satspares/LDMOS_Controller/DWIN/Display 800x480/PS32/15.bmp

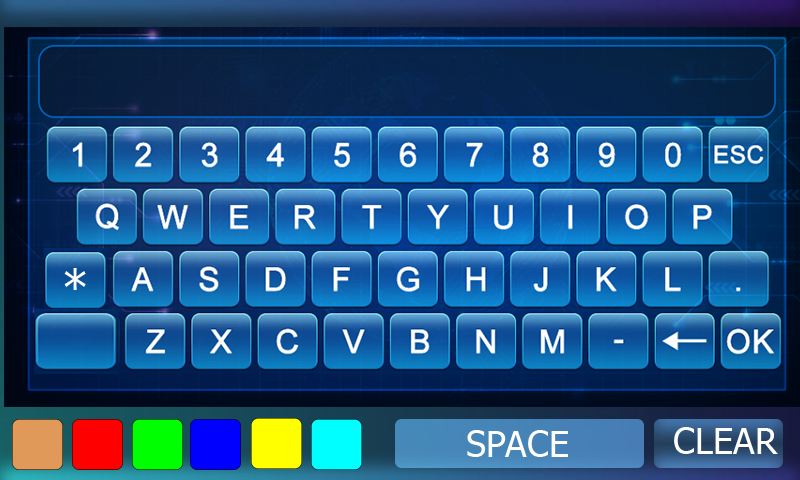
DWIN/Display 800x480/PS32/15.bmp
