satspares/LDMOS_Controller/README.md

# LDMOS_Controller
LDMOS Controller with DWIN Display
New October 2026
