satspares/LDMOS_Controller/Kicad/Kicad-all-band-amp-April-2026/all-band-amp-April-2026/report.txt

Info: Processing symbol 'L1:Inductor_THT:L_Radial_D7.0mm_P3.00mm'.
Info: Processing symbol 'J18:Connector_JST:JST_EH_B2B-EH-A_1x02_P2.50mm_Vertical'.
Info: Processing symbol 'J19:Connector_JST:JST_EH_B3B-EH-A_1x03_P2.50mm_Vertical'.
Info: Processing symbol 'J20:Connector_JST:JST_EH_B2B-EH-A_1x02_P2.50mm_Vertical'.
Info: Processing symbol 'J21:Connector_JST:JST_EH_B2B-EH-A_1x02_P2.50mm_Vertical'.
Info: Processing symbol 'J22:Connector_JST:JST_EH_B3B-EH-A_1x03_P2.50mm_Vertical'.
Info: Processing symbol 'J23:Connector_JST:JST_EH_B2B-EH-A_1x02_P2.50mm_Vertical'.
Info: Processing symbol 'J24:Connector_JST:JST_EH_B2B-EH-A_1x02_P2.50mm_Vertical'.
Info: Processing symbol 'J25:Connector_JST:JST_EH_B3B-EH-A_1x03_P2.50mm_Vertical'.
Info: Processing symbol 'JP1:Connector_Wire:SolderWire-0.5sqmm_1x02_P4.8mm_D0.9mm_OD2.3mm'.
Info: Processing symbol 'A1:my-footprints:DIP-34_W15.24mm'.
Info: Processing symbol 'J17:Connector_JST:JST_EH_B2B-EH-A_1x02_P2.50mm_Vertical'.
Info: Processing symbol 'Q1:Package_TO_SOT_THT:TO-92_HandSolder'.
Info: Processing symbol 'R1:Resistor_THT:R_Axial_DIN0207_L6.3mm_D2.5mm_P7.62mm_Horizontal'.
Info: Processing symbol 'R2:Resistor_THT:R_Axial_DIN0207_L6.3mm_D2.5mm_P7.62mm_Horizontal'.
Info: Processing symbol 'R3:Resistor_THT:R_Axial_DIN0207_L6.3mm_D2.5mm_P7.62mm_Horizontal'.
Info: Processing symbol 'R4:Resistor_THT:R_Axial_DIN0207_L6.3mm_D2.5mm_P7.62mm_Horizontal'.
Info: Processing symbol 'R5:Resistor_THT:R_Axial_DIN0207_L6.3mm_D2.5mm_P7.62mm_Horizontal'.
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
Updated J25 fields.
Updated J24 sheetfile to 'all-band-amp-2026.kicad_sch'.
Updated J24 sheetname to '/'.
Updated J24 fields.
Updated C15 fields.
Updated J23 sheetfile to 'all-band-amp-2026.kicad_sch'.
Updated J23 sheetname to '/'.
Updated J23 fields.

Info: Total warnings: 0, errors: 0.
