satspares/LDMOS_Controller/DWIN/Display 800x480/DWIN_SET/0.bmp

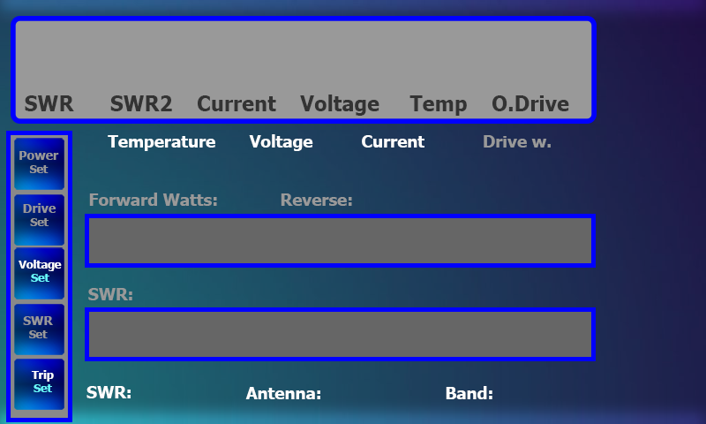
DWIN/Display 800x480/DWIN_SET/0.bmp
