satspares/LDMOS_Controller/DWIN/Display 800x480/DWIN_SET/10.bmp

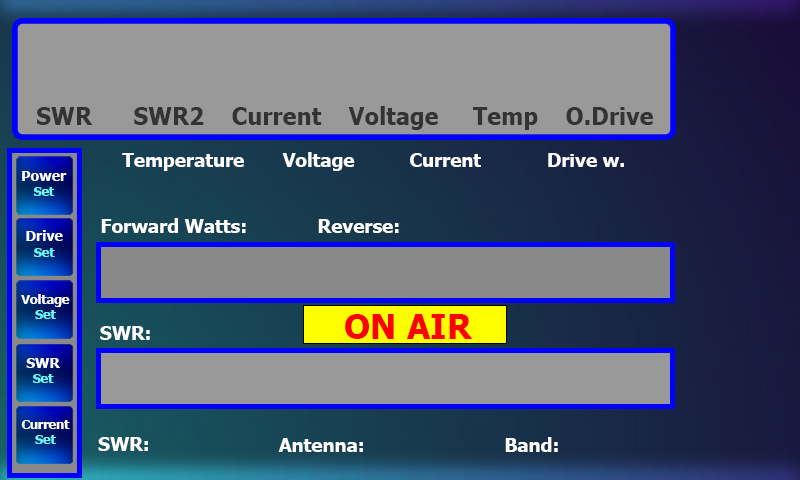
DWIN/Display 800x480/DWIN_SET/10.bmp
