satspares/LDMOS_Controller/DWIN/Display 800x480/PS32/dark.png

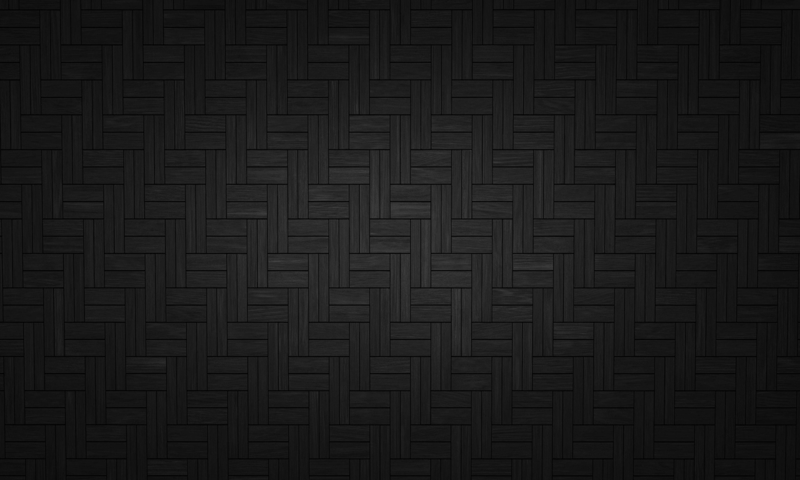
DWIN/Display 800x480/PS32/dark.png
