satspares/LDMOS_Controller/DWIN/Display_800x480_Single_Band/DWIN_SET/0.bmp

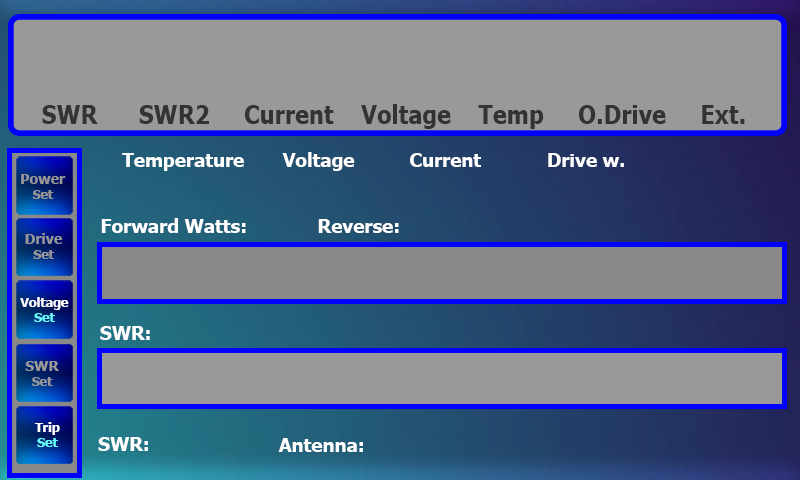
DWIN/Display_800x480_Single_Band/DWIN_SET/0.bmp
