satspares/LDMOS_Controller/DWIN/Display_800x480_Single_Band/PS32/16.bmp

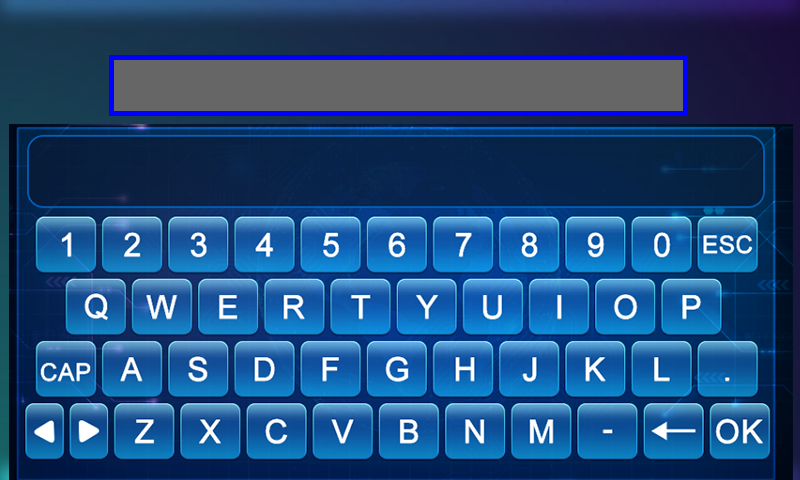
DWIN/Display_800x480_Single_Band/PS32/16.bmp
