satspares/LDMOS_Controller/Kicad/RFA_Board/sm_red_top.png

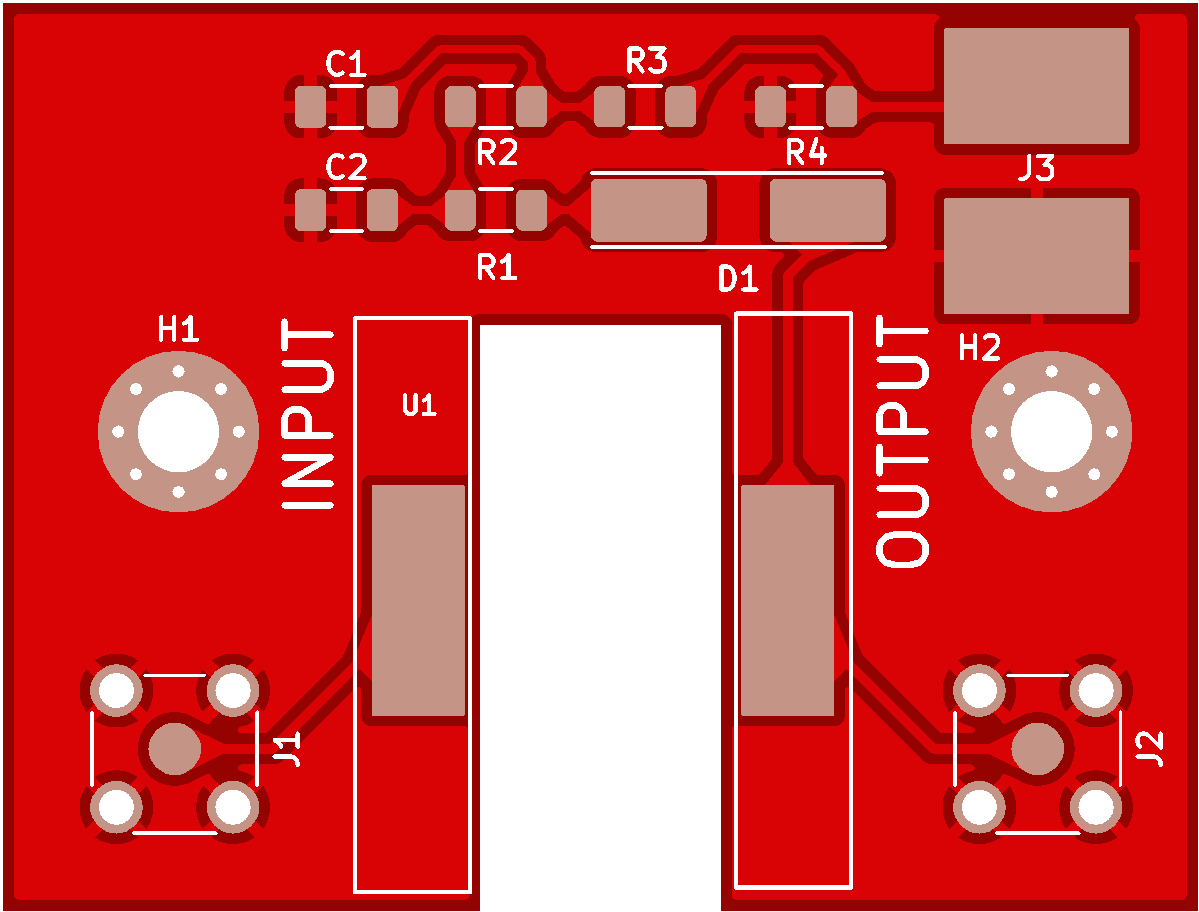
Kicad/RFA_Board/sm_red_top.png
