satspares/LDMOS_Controller/Kicad/Band_Switch_board_2026/components.txt

Capacitor_THT:C_Disc_D3.4mm_W2.1mm_P2.50mm

Capacitor_THT:C_Disc_D6.0mm_W2.5mm_P5.00mm

Diode_THT:D_DO-35_SOD27_P7.62mm_Horizontal

Resistor_THT:R_Axial_DIN0207_L6.3mm_D2.5mm_P7.62mm_Horizontal
