satspares/LDMOS_Controller/Kicad/LTC-7001-Trip_B-SMD-Mod/production/bom.csv

Designator | Footprint | Quantity | Value | LCSC Part #
C1, C13 | C_Disc_D3.8mm_W2.6mm_P2.50mm | 2 | 100nf 100v
C10, C11 | C_Disc_D3.8mm_W2.6mm_P2.50mm | 2 | 10uf
C12, C4 | C_Disc_D3.8mm_W2.6mm_P2.50mm | 2 | 10nf
C2, C22, C3, C6, C8, C9 | C_Disc_D3.8mm_W2.6mm_P2.50mm | 6 | 100nf
C23 | CP_Radial_D10.0mm_P5.00mm | 1 | 10uf-220uf 100v
C25, C27, C7 | C_Disc_D3.4mm_W2.1mm_P2.50mm | 3 | 10nf
C5 | C_Disc_D3.8mm_W2.6mm_P2.50mm | 1 | 1uf
CN1 | CONN-TH_8P-P2.54_KF141R-2.54-8P | 1 | ~
D1, D3 | D_DO-41_SOD81_P10.16mm_Horizontal | 2 | UF4007
D2 | D_DO-35_SOD27_P7.62mm_Horizontal | 1 | 5.1v Zener
FB1, FB2 | 1206 | 2 | Ferrite
IC1 | SOP50P490X110-11N | 1 | LTC7001HMSE#PBF
K2 | HK4100FDC5VSHG | 1 | HK4100F-DC12V-SHG
Q1 | IAUT150N10S5N035ATMA1 | 1 | IPT010N08NM5ATM1
Q2, Q3, Q4, Q5, Q7 | TO-92-mod2 | 5 | 2N7000
Q6 | TO-92_HandSolder | 1 | bc547
R1 | R_Axial_DIN0207_L6.3mm_D2.5mm_P7.62mm_Horizontal | 1 | 10r
R10, R12, R8 | R_Axial_DIN0207_L6.3mm_D2.5mm_P7.62mm_Horizontal | 3 | 1k
R11, R14, R7, R9 | R_Axial_DIN0207_L6.3mm_D2.5mm_P7.62mm_Horizontal | 4 | 10k
R13 | R_Axial_DIN0207_L6.3mm_D2.5mm_P7.62mm_Horizontal | 1 | 2k2
R2, R3 | RESC11050X120N | 2 | 100r
R4 | R_Axial_DIN0207_L6.3mm_D2.5mm_P7.62mm_Horizontal | 1 | 47k
R43 | RESC11050X120N | 1 | Shunt I>30a
R5 | R_Axial_DIN0207_L6.3mm_D2.5mm_P7.62mm_Horizontal | 1 | 4k7
R6 | R_Axial_DIN0207_L6.3mm_D2.5mm_P7.62mm_Horizontal | 1 | 100k
RV1 | Potentiometer_Bourns_3296W_Vertical | 1 | 1k
SW1 | SW_PUSH_6mm | 1 | Test Enable
TP1 | TestPoint_THTPad_3.0x3.0mm_Drill1.5mm | 1 | LM393 - in
TP2 | TestPoint_THTPad_3.0x3.0mm_Drill1.5mm | 1 | +5v
TP3 | TestPoint_THTPad_3.0x3.0mm_Drill1.5mm | 1 | i_Sense
TP4 | TestPoint_THTPad_3.0x3.0mm_Drill1.5mm | 1 | INP
U1 | SOP-8_3.76x4.96mm_P1.27mm | 1 | LMV393
U2 | TO-92_Inline-mod | 1 | L78L05_TO92
U9 | SOIC-8_3.9x4.9mm_P1.27mm | 1 | ACS712xLCTR-30A
