satspares/LDMOS_Controller/Kicad/Kicad-all-band-amp-April-2026/all-band-amp-April-2026/production/bom.csv

Designator | Footprint | Quantity | Value | LCSC Part #
A1 | DIP-34_W15.24mm | 1 | Arduino_Nano_Every-4808
C1, C18, C19, C2, C20, C21, C25, C26, C27, C3, C4, C5, C6 | C_Disc_D3.4mm_W2.1mm_P2.50mm | 13 | 10nf
C10, C17 | CP_Radial_D5.0mm_P2.00mm | 2 | 2.2uf
C11, C7 | CP_Radial_D5.0mm_P2.00mm | 2 | 10uf
C12, C22, C24, C8, C9 | C_Disc_D6.0mm_W2.5mm_P5.00mm | 5 | 100nf
C13, C14, C15, C16 | CP_Radial_D5.0mm_P2.00mm | 4 | 1uf
C23 | CP_Radial_D10.0mm_P5.00mm | 1 | 10uf-220uf
D1, D2, D3, D4, D5, D6 | D_DO-35_SOD27_P7.62mm_Horizontal | 6 | Zener 4.7v
D10, D11, D12, D7, D8, D9 | D_DO-35_SOD27_P7.62mm_Horizontal | 6 | BAT85
FB1, FB2, FB4, FB5, FB6, FB7, FB8, FB9 | 1206 | 8 | Ferrite
J1 | JST_EH_B3B-EH-A_1x03_P2.50mm_Vertical-mod2 | 1 | SWR1
J10 | JST_EH_B2B-EH-A_1x02_P2.50mm_Vertical-Mod | 1 | Aux In
J11 | JST_EH_B8B-EH-A_1x08_P2.50mm_Vertical | 1 | LPF
J12 | JST_EH_B4B-EH-A_1x04_P2.50mm_Vertical-mod2 | 1 | Digi In/Out
J13 | JST_EH_B4B-EH-A_1x04_P2.50mm_Vertical-mod2 | 1 | 12v/5v Outputs
J14 | JST_EH_B2B-EH-A_1x02_P2.50mm_Vertical-Mod | 1 | TX2/RX2
J15 | JST_EH_B2B-EH-A_1x02_P2.50mm_Vertical-Mod | 1 | TX0/RX0
J16, J5 | JST_EH_B2B-EH-A_1x02_P2.50mm_Vertical-Mod | 2 | 50v In.
J17 | JST_EH_B2B-EH-A_1x02_P2.50mm_Vertical-Mod | 1 | PWM Out
J18 | JST_EH_B2B-EH-A_1x02_P2.50mm_Vertical-Mod | 1 | PTT IN
J19 | JST_EH_B3B-EH-A_1x03_P2.50mm_Vertical-mod2 | 1 | DISPLAY POWER
J2 | JST_EH_B3B-EH-A_1x03_P2.50mm_Vertical-mod2 | 1 | SWR2
J20 | JST_EH_B2B-EH-A_1x02_P2.50mm_Vertical-Mod | 1 | 5V Output
J21 | JST_EH_B2B-EH-A_1x02_P2.50mm_Vertical-Mod | 1 | RS232
J22 | JST_EH_B3B-EH-A_1x03_P2.50mm_Vertical | 1 | UDPI
J23, J24 | JST_EH_B2B-EH-A_1x02_P2.50mm_Vertical-Mod | 2 | 12v Output
J27, J28, J29, J30, J31 | JST_EH_B2B-EH-A_1x02_P2.50mm_Vertical-Mod | 5 | SWR trip out
J3 | JST_EH_B2B-EH-A_1x02_P2.50mm_Vertical-Mod | 1 | I opt Input
J4 | JST_EH_B2B-EH-A_1x02_P2.50mm_Vertical-Mod | 1 | RF In Level
J6 | JST_EH_B3B-EH-A_1x03_P2.50mm_Vertical-mod2 | 1 | Temp
J7 | JST_EH_B3B-EH-A_1x03_P2.50mm_Vertical-mod2 | 1 | Conn_01x03_Pin
J8 | JST_EH_B2B-EH-A_1x02_P2.50mm_Vertical-Mod | 1 | 12v Input
J9 | JST_EH_B4B-EH-A_1x04_P2.50mm_Vertical-mod2 | 1 | I2c Output
JP1 | SolderWire-0.5sqmm_1x02_P4.8mm_D0.9mm_OD2.3mm | 1 | Jumper 12v
JP2 | SolderWire-0.5sqmm_1x02_P4.8mm_D0.9mm_OD2.3mm | 1 | Jumper 5v
JP3, JP4 | SolderJumper-2_P1.3mm_Open_TrianglePad1.0x1.5mm | 2 | Jumper_2_Open
L1 | L_Radial_D7.0mm_P3.00mm | 1 | 68uh
L2 | L_Axial_L5.3mm_D2.2mm_P7.62mm_Horizontal_Vishay_IM-1 | 1 | 560uh
Q1, Q2 | TO-92_HandSolder | 2 | 2n2222
R1, R44, R45, R46, R9 | R_Axial_DIN0207_L6.3mm_D2.5mm_P7.62mm_Horizontal | 5 | 1k5
R10, R8 | R_Axial_DIN0207_L6.3mm_D2.5mm_P7.62mm_Horizontal | 2 | 100r
R11 | R_Axial_DIN0204_L3.6mm_D1.6mm_P5.08mm_Horizontal | 1 | 4k7
R12 | R_Axial_DIN0204_L3.6mm_D1.6mm_P5.08mm_Horizontal | 1 | 470r
R13 | R_Axial_DIN0207_L6.3mm_D2.5mm_P7.62mm_Horizontal | 1 | 100k
R14 | R_Axial_DIN0207_L6.3mm_D2.5mm_P7.62mm_Horizontal | 1 | 5k1
R15, R24, R25 | R_Axial_DIN0207_L6.3mm_D2.5mm_P7.62mm_Horizontal | 3 | 4k7
R16, R42 | R_Axial_DIN0207_L6.3mm_D2.5mm_P7.62mm_Horizontal | 2 | 2k2
R17, R18, R19 | R_Axial_DIN0207_L6.3mm_D2.5mm_P7.62mm_Horizontal | 3 | 10r
R2, R4 | R_Axial_DIN0207_L6.3mm_D2.5mm_P7.62mm_Horizontal | 2 | 680r
R20, R21, R22, R23, R26, R27, R30, R31, R32, R33, R36 | R_Axial_DIN0207_L6.3mm_D2.5mm_P7.62mm_Horizontal | 11 | 10k
R28, R29 | R_Axial_DIN0207_L6.3mm_D2.5mm_P7.62mm_Horizontal | 2 | 470r
R3, R7 | R_Axial_DIN0207_L6.3mm_D2.5mm_P7.62mm_Horizontal | 2 | 1k5-3k3
R34 | R_Axial_DIN0207_L6.3mm_D2.5mm_P7.62mm_Horizontal | 1 | 3k3
R35, R40, R47 | R_Axial_DIN0207_L6.3mm_D2.5mm_P7.62mm_Horizontal | 3 | 1k
R37, R38 | R_Axial_DIN0207_L6.3mm_D2.5mm_P7.62mm_Horizontal | 2 | R
R39, R41 | R_Axial_DIN0207_L6.3mm_D2.5mm_P7.62mm_Horizontal | 2 | 220k-1M
R43 | CHSA3920R0003F-MOD | 1 | Shunt I>30a
R48 | R_Axial_DIN0207_L6.3mm_D2.5mm_P7.62mm_Horizontal | 1 | DNF
R5 | R_Axial_DIN0207_L6.3mm_D2.5mm_P7.62mm_Horizontal | 1 | 470r or 47k opt
R6 | R_Axial_DIN0207_L6.3mm_D2.5mm_P7.62mm_Horizontal | 1 | 47k opt
RV1, RV2 | Potentiometer_Bourns_3299Y_Vertical | 2 | 1k
U1 | DIP-16_W7.62mm | 1 | LTV-847
U2 | DIP-28_W7.62mm | 1 | MCP23017_SP
U3 | DIP-8_W7.62mm | 1 | LM393
U4, U5 | DIP-18_W7.62mm_Socket | 2 | MIC2981/82YN
U6 | Converter_DCDC_RECOM_R-78E-0.5_THT | 1 | R-78E5.0-1.0
U7 | DIP-16_W7.62mm | 1 | MAX232N
U8 | DIP-8_W7.62mm | 1 | LTV-827
U9 | SOIC-8_3.9x4.9mm_P1.27mm | 1 | ACS712xLCTR-30A
