satspares/LDMOS_Controller/Kicad/Band_Switch_board_2026/Band_Switch_board_2026_small/KMDGX-8S-N/3D/KMDGX-8S-N.stp

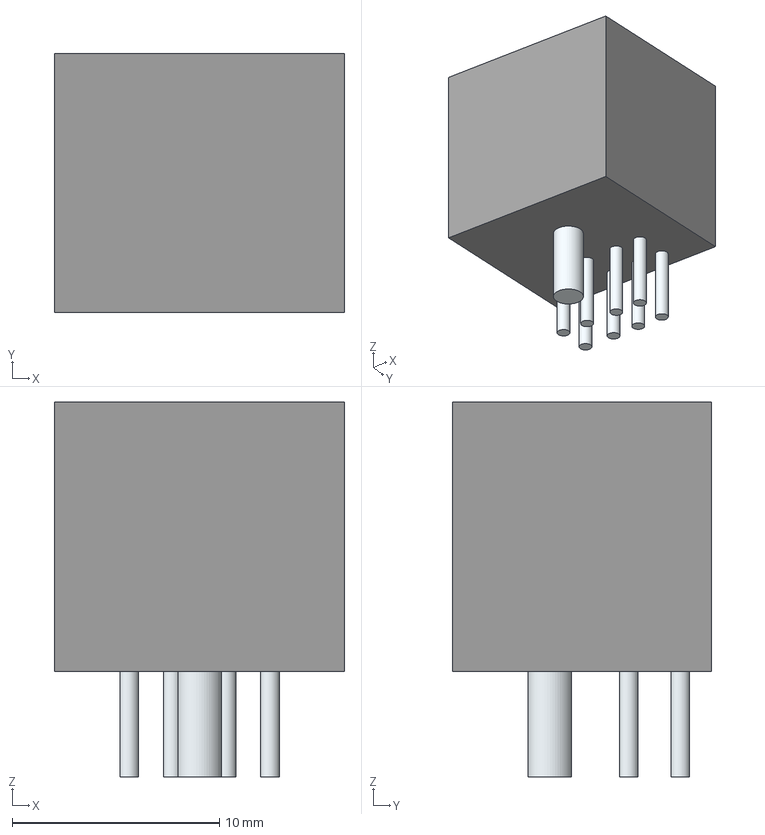
[picture p12: CAD file, 2026-10-16]
Kicad/Band_Switch_board_2026/Band_Switch_board_2026_small/KMDGX-8S-N/3D/KMDGX-8S-N.stp
14.0 x 12.5 x 18.1 mm
Leads x 9
