satspares/LDMOS_Controller/Kicad/Kicad-all-band-amp-April-2026/all-band-amp-April-2026/CHSA3920R0003F/3D/CHSA3920R0003F.stp

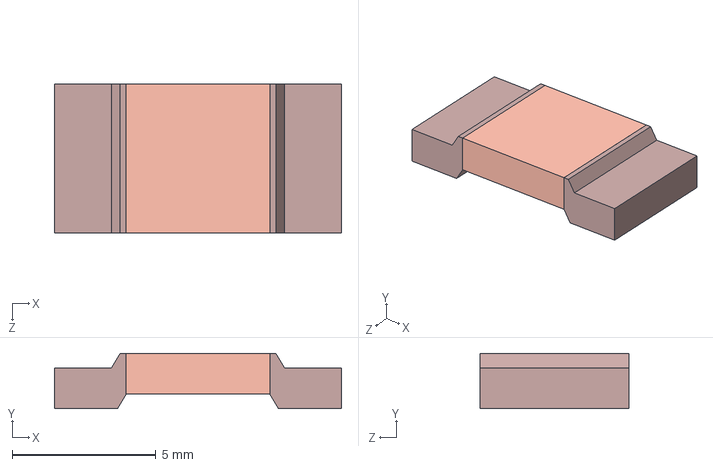
[picture p13: CAD file, 2026-10-16]
Kicad/Kicad-all-band-amp-April-2026/all-band-amp-April-2026/CHSA3920R0003F/3D/CHSA3920R0003F.stp
10.0 x 1.92 x 5.20 mm
