satspares/LDMOS_Controller/Kicad/RFA-Board-2026/RFA-Board-2026/IM26GR.stp

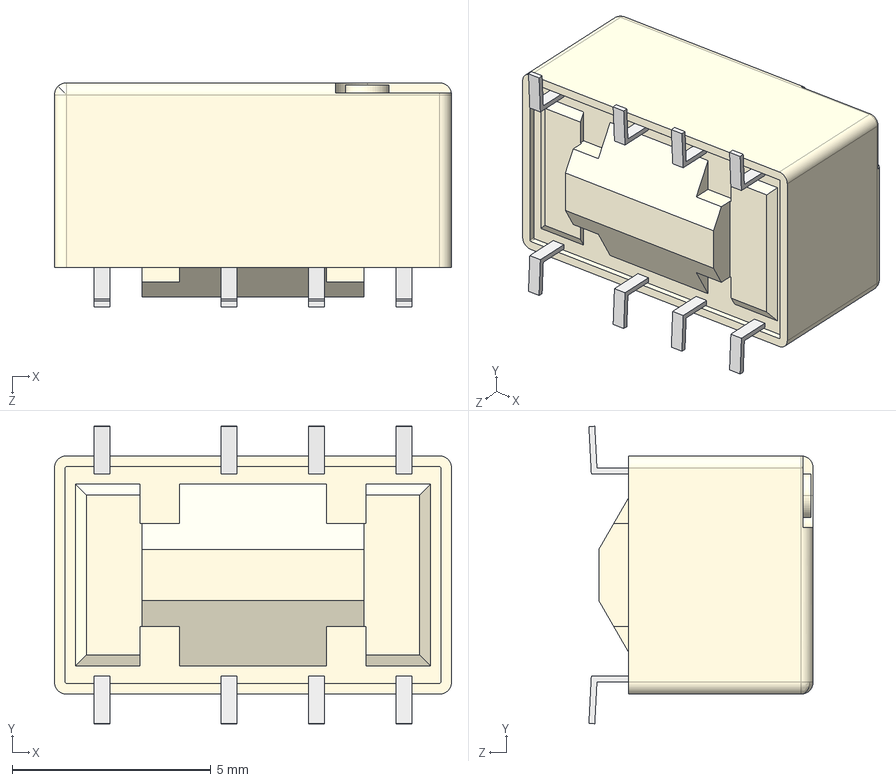
[picture p14: CAD file, 2026-10-16]
Kicad/RFA-Board-2026/RFA-Board-2026/IM26GR.stp
10.0 x 7.50 x 5.65 mm
