satspares/LDMOS_Controller/Kicad/N-CON_BOARD-2026-old/N-Con-Board-2026/Footprints/HK4100F-DC5V-SHG.step

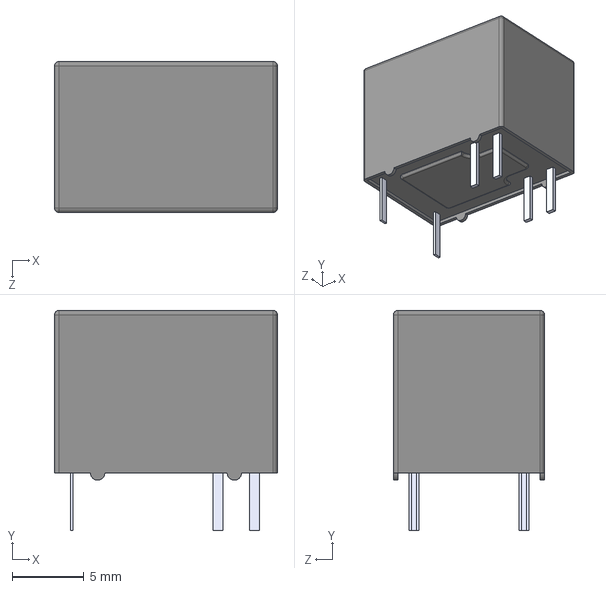
[picture p15: CAD file, 2026-10-16, an earlier design]
Kicad/N-CON_BOARD-2026-old/N-Con-Board-2026/Footprints/HK4100F-DC5V-SHG.step
15.5 x 15.3 x 10.5 mm
