satspares/LDMOS_Controller/(list of files, cad)

Other CAD files:
Kicad/Band_Switch_board_2026/Band_Switch_board_2026_small/KMDGX-8S-N/Allegro/kmdgx8sn.psm
Kicad/Band_Switch_board_2026/Band_Switch_board_2026_small/KMDGX-8S-N/DEHDL/kmdgx_8s_n/chips/chips.prt
Kicad/Kicad-all-band-amp-April-2026/all-band-amp-April-2026/CHSA3920R0003F/Allegro/chsa3920r0003f.psm
Kicad/Kicad-all-band-amp-April-2026/all-band-amp-April-2026/CHSA3920R0003F/DEHDL/chsa3920r0003f/chips/chips.prt
Kicad/RFA-Board-2026/RFA-Board-2026/3550100RJT/Allegro/resc11050x120n.psm
Kicad/RFA-Board-2026/RFA-Board-2026/3550100RJT/DEHDL/3550100rjt/chips/chips.prt
Kicad/RFA-Board-2026/RFA-Board-2026/IM26GR/Allegro/im07gr.psm
Kicad/RFA-Board-2026/RFA-Board-2026/IM26GR/DEHDL/im26gr/chips/chips.prt
