satspares/LDMOS_Controller/Kicad/LTC-7001-Trip_B-SMD-Mod/Symbols/DG141R-2.54.pdf

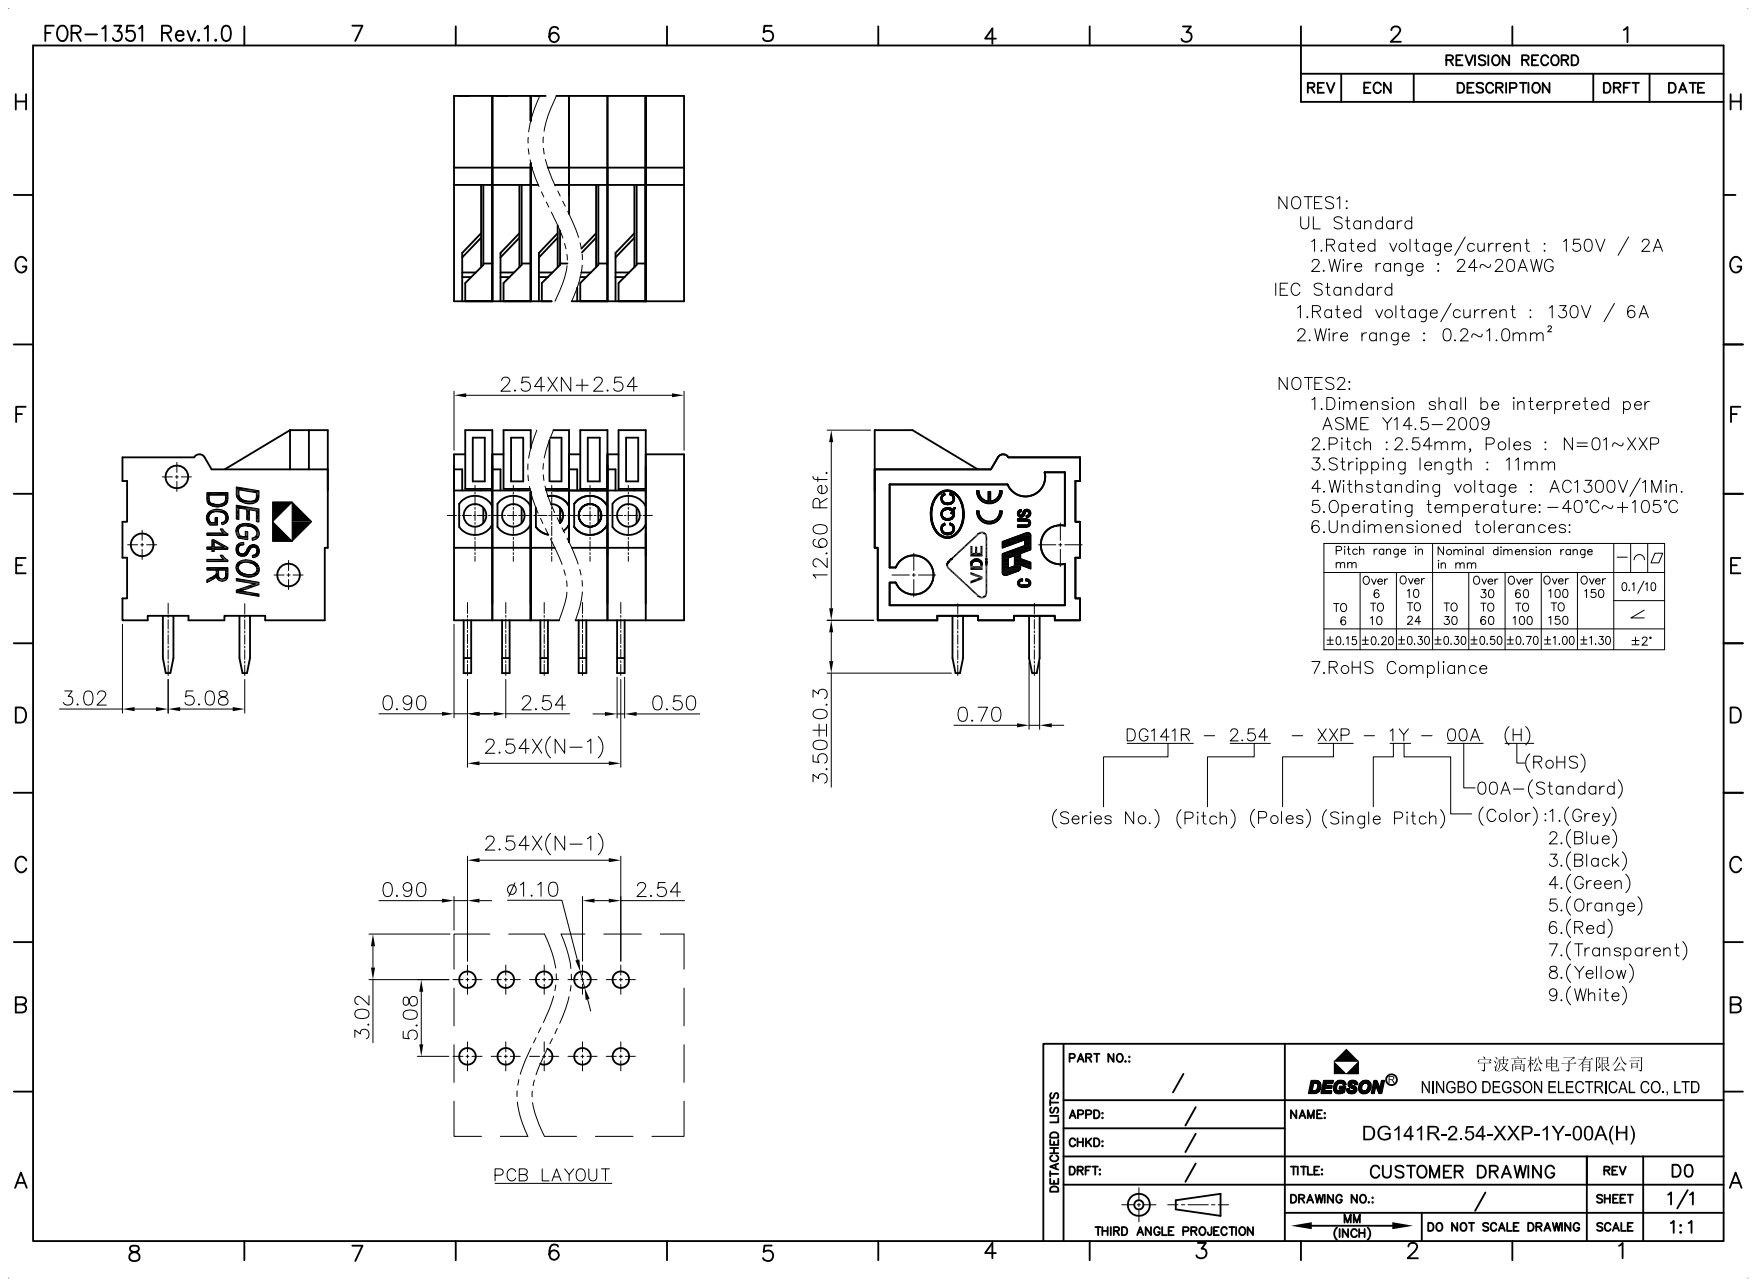
[picture p16: page 1]
