satspares/LDMOS_Controller/(list of files, drawings)

Other design files:
Kicad/Band_Switch_board_2026/Band_Switch_board_2026_small/KMDGX-8S-N/Altium/KMDGX8SN.PcbLib
Kicad/Band_Switch_board_2026/Band_Switch_board_2026_small/KMDGX-8S-N/Altium/KMDGX-8S-N.SchLib
Kicad/Kicad-all-band-amp-April-2026/all-band-amp-April-2026/CHSA3920R0003F/Altium/CHSA3920R0003F.PcbLib
Kicad/Kicad-all-band-amp-April-2026/all-band-amp-April-2026/CHSA3920R0003F/Altium/CHSA3920R0003F.SchLib
Kicad/RFA-Board-2026/RFA-Board-2026/3550100RJT/Altium/3550100RJT.SchLib
Kicad/RFA-Board-2026/RFA-Board-2026/3550100RJT/Altium/RESC11050X120N.PcbLib
Kicad/RFA-Board-2026/RFA-Board-2026/RFA-Board-2026.dsn
