satspares/LDMOS_Controller/Kicad/N-Con-Board-2026/N-Con-Board-2026.kicad_pcb

## KiCad design Kicad/N-Con-Board-2026/N-Con-Board-2026.kicad_pcb (2026-10-17)

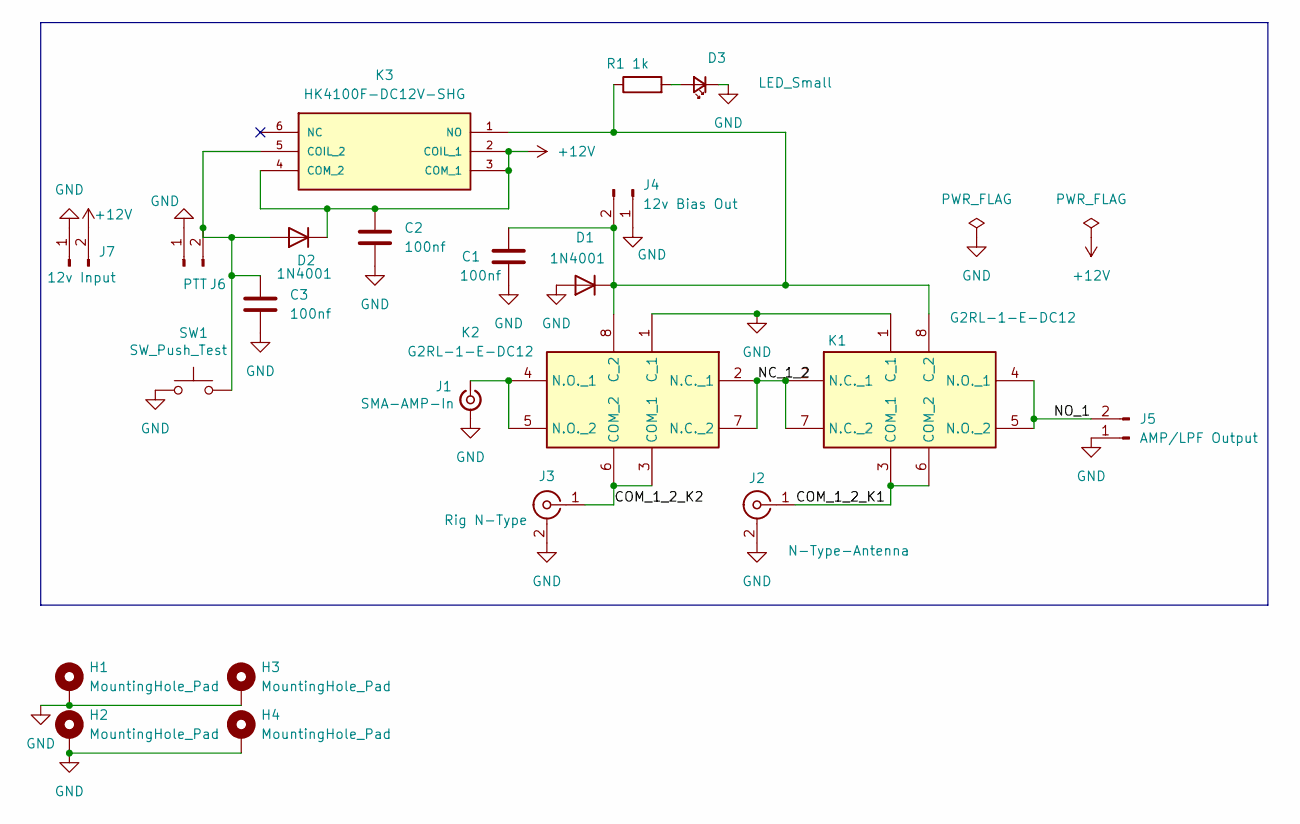
[picture p17: schematic N-Con-Board-2026.kicad_sch]

Parts:
C1, C2, C3: 100nf; C_Disc_D6.0mm_W2.5mm_P5.00mm
D1, D2: 1N4001; D_DO-41_SOD81_P10.16mm_Horizontal
D3: LED_Small; LED_D3.0mm
H1, H2, H3, H4: MountingHole_Pad; MountingHole_3.5mm_Pad_Via
J1: SMA-AMP-In; SMA_Amphenol_132134_Vertical
J2: N-Type-Antenna; N_TYPE
J3: Rig N-Type; N_TYPE
J4: 12v Bias Out; JST_EH_B2B-EH-A_1x02_P2.50mm_Vertical
J5: AMP/LPF Output; SolderWirePad_1x02_SMD_11x6mm
J6: PTT; JST_EH_B2B-EH-A_1x02_P2.50mm_Vertical
J7: 12v Input; JST_EH_B2B-EH-A_1x02_P2.50mm_Vertical
K1, K2: G2RL-1-E-DC12; G2RL1EDC24; Mouser Part Number 653-G2RL-1-E-DC12
K3: HK4100F-DC12V-SHG; HK4100FDC5VSHG; MANUFACTURER_PART_NUMBER HK4100F-DC5V-SHG
R1: 1k; R_Axial_DIN0207_L6.3mm_D2.5mm_P7.62mm_Horizontal
SW1: SW_Push_Test; SW_PUSH_6mm

Connections:
+12V: C2.1, D2.1 (K), J7.2, K3.2 (COIL_1), K3.3 (COM_1), K3.4 (COM_2)
/COM_1_2_K1: J2.1 (In), K1.3 (COM_1), K1.6 (COM_2)
/COM_1_2_K2: J3.1 (In), K2.3 (COM_1), K2.6 (COM_2)
/NC_1_2: K1.2 (N.C._1), K1.7 (N.C._2), K2.2 (N.C._1), K2.7 (N.C._2)
/NO_1: J5.2, K1.4 (N.O._1), K1.5 (N.O._2)
GND: C1.2, C2.2, C3.2, D1.2 (A), D3.1 (K), H1.1 (1_1), H2.1 (1_1), H3.1 (1_1), H4.1 (1_1), J1.2 (Ext), J2.2 (Ext), J3.2 (Ext), J4.1, J5.1, J6.1, J7.1, K1.1 (C_1), K2.1 (C_1), SW1.1
unnamed: C1.1, D1.1 (K), J4.2, K1.8 (C_2), K2.8 (C_2), K3.1 (NO), R1.1
unnamed: C3.1, D2.2 (A), J6.2, K3.5 (COIL_2), SW1.2
unnamed: D3.2 (A), R1.2
unnamed: J1.1 (In), K2.4 (N.O._1), K2.5 (N.O._2)

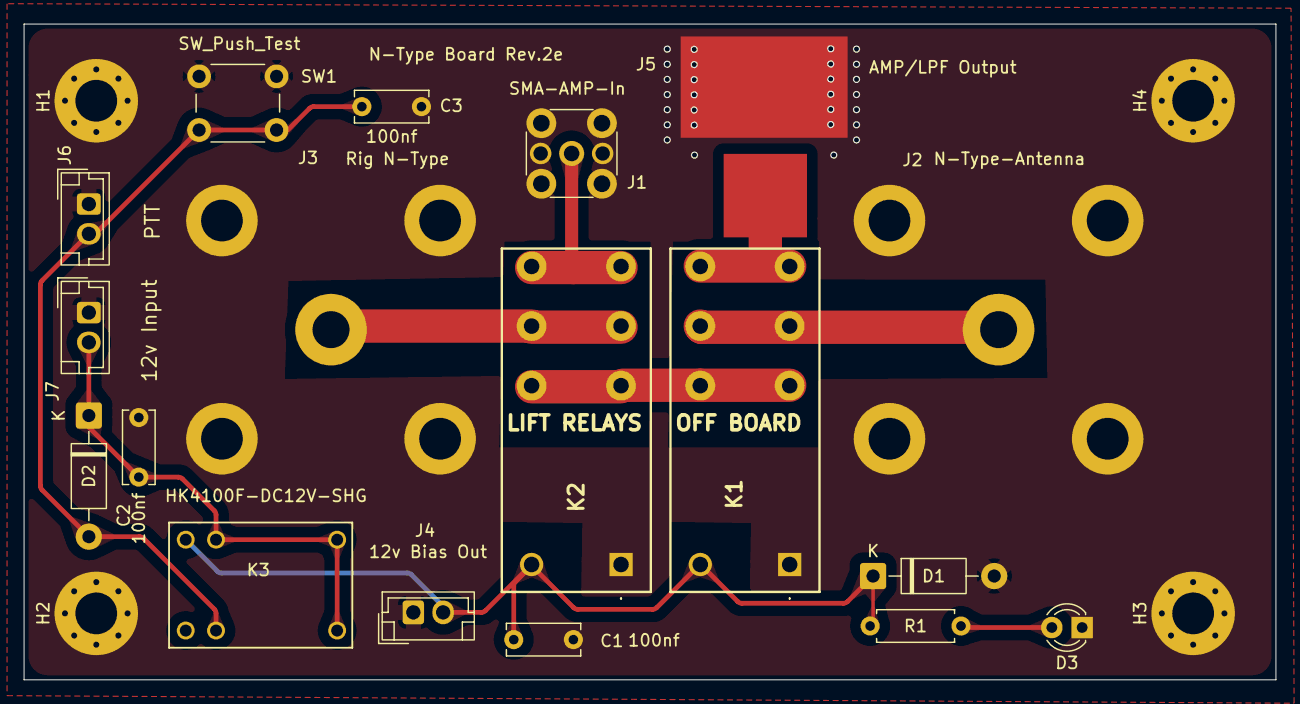
[picture p18: board N-Con-Board-2026.kicad_pcb from above]

Board: 2 copper layers, 105.0 x 55.0 mm, 22 parts (0 on the bottom side), 10 nets.
