satspares/LDMOS_Controller/Kicad/LTC-7001-Trip_B/LTC-7001-Trip_B.kicad_pcb

## KiCad design Kicad/LTC-7001-Trip_B/LTC-7001-Trip_B.kicad_pcb (2026-10-16)

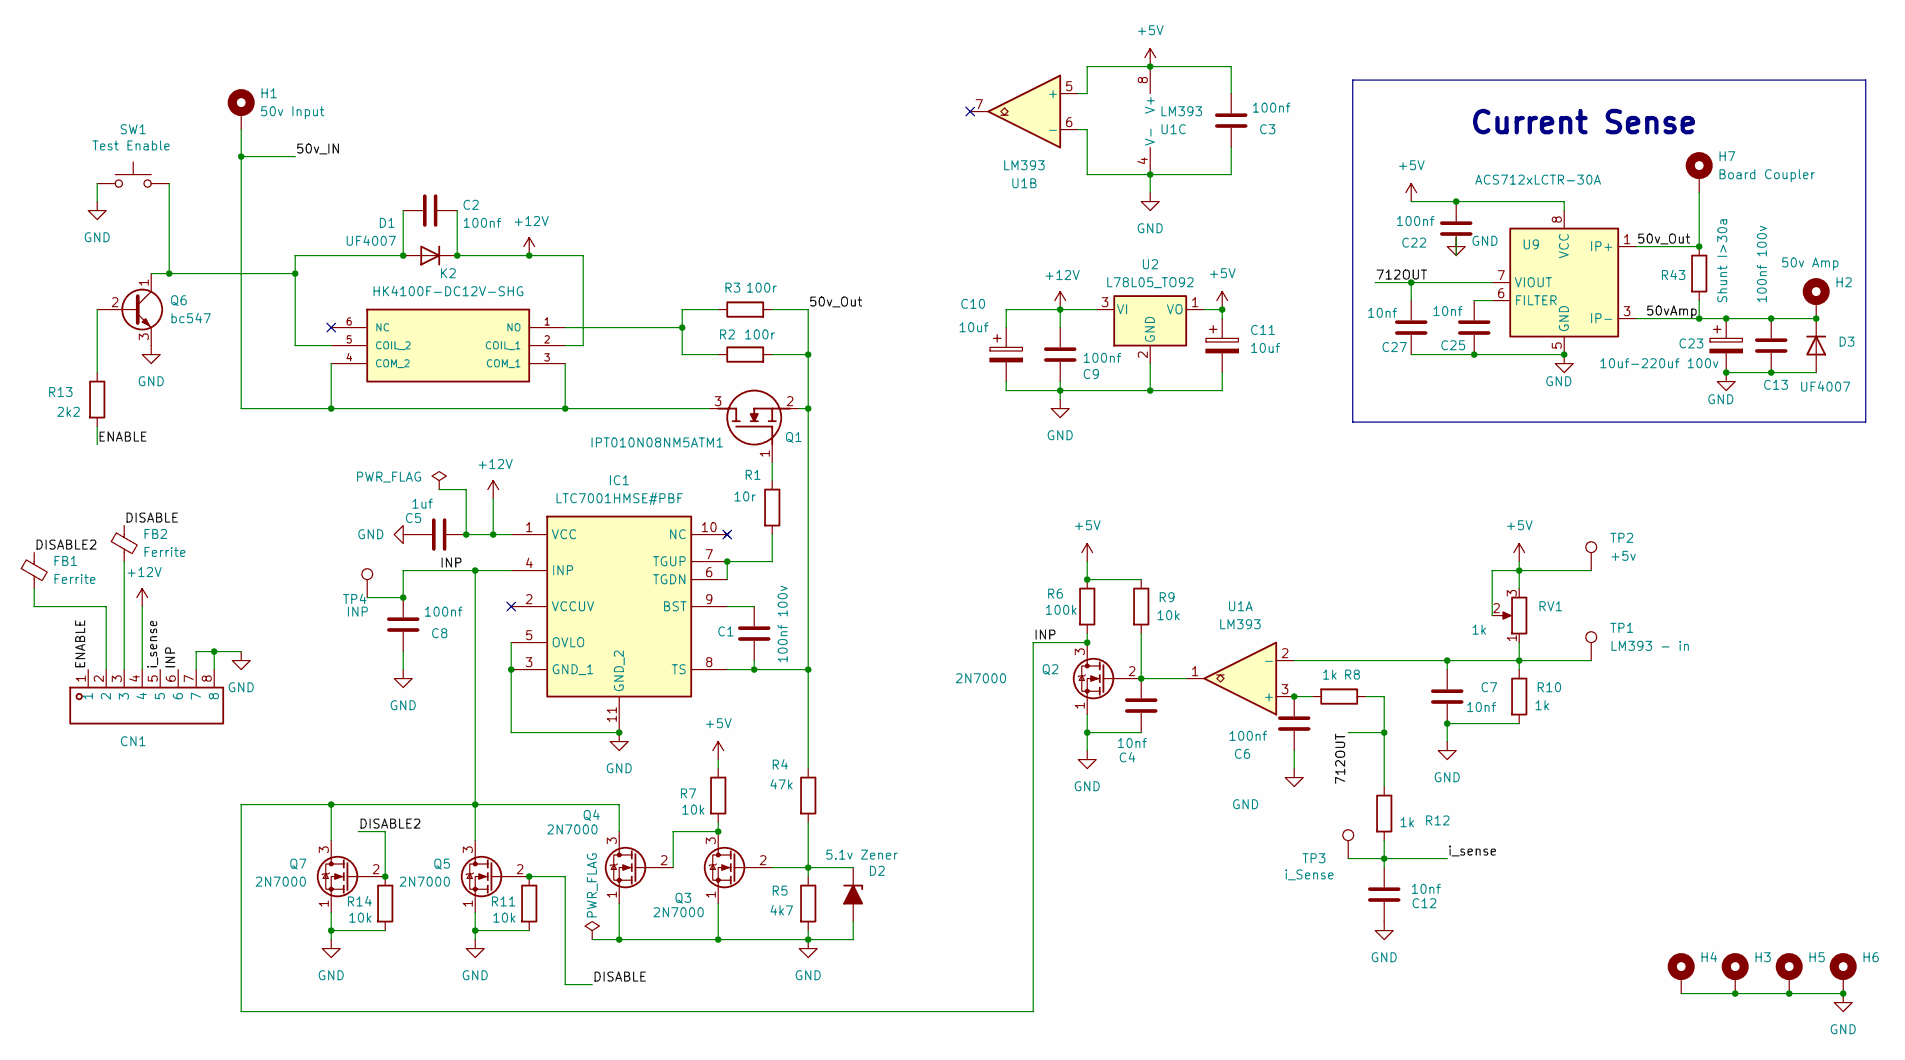
[picture p19: schematic LTC-7001-Trip_B.kicad_sch]

Parts:
C1, C13: 100nf 100v; C_Disc_D3.8mm_W2.6mm_P2.50mm
C2, C3, C6, C8, C9, C22: 100nf; C_Disc_D3.8mm_W2.6mm_P2.50mm
C4, C12: 10nf; C_Disc_D3.8mm_W2.6mm_P2.50mm
C5: 1uf; C_Disc_D3.8mm_W2.6mm_P2.50mm
C7, C25, C27: 10nf; C_Disc_D3.4mm_W2.1mm_P2.50mm
C10, C11: 10uf; C_Disc_D3.8mm_W2.6mm_P2.50mm
C23: 10uf-220uf 100v; CP_Radial_D10.0mm_P5.00mm
CN1: CONN-TH_8P-P2.54_KF141R-2.54-8P; Manufacturer Part KF141R-2.54-8P; LCSC Part Name 1x6P 2.54mm 每排P数:8 排数:1
D1, D3: UF4007; D_DO-41_SOD81_P10.16mm_Horizontal
D2: 5.1v Zener; D_DO-35_SOD27_P7.62mm_Horizontal
FB1, FB2: Ferrite; R_1206_3216Metric_Pad1.30x1.75mm_HandSolder
H1: 50v Input; Power-Pad
H2: 50v Amp; Power-Pad
H3, H4, H5, H6: MountingHole_Pad; MountingHole_3.5mm_Pad_Via
H7: Board Coupler; MountingHole_3.5mm_Pad_Via
IC1: LTC7001HMSE#PBF; SOP50P490X110-11N; Manufacturer_Part_Number LTC7001HMSE#PBF; Mouser Part Number 584-LTC7001HMSEPBF
K2: HK4100F-DC12V-SHG; HK4100FDC5VSHG; MANUFACTURER_PART_NUMBER HK4100F-DC5V-SHG
Q1: IPT010N08NM5ATM1; IAUT150N10S5N035ATMA1; Manufacturer_Part_Number FDP083N15A-F102; Mouser Part Number 512-FDP083N15A_F102
Q2, Q3, Q4, Q5, Q7: 2N7000; TO-92-mod2
Q6: bc547; TO-92_HandSolder
R1: 10r; R_Axial_DIN0207_L6.3mm_D2.5mm_P7.62mm_Horizontal
R2, R3: 100r; RESC11050X120N
R4: 47k; R_Axial_DIN0207_L6.3mm_D2.5mm_P7.62mm_Horizontal
R5: 4k7; R_Axial_DIN0207_L6.3mm_D2.5mm_P7.62mm_Horizontal
R6: 100k; R_Axial_DIN0207_L6.3mm_D2.5mm_P7.62mm_Horizontal
R7, R9, R11, R14: 10k; R_Axial_DIN0207_L6.3mm_D2.5mm_P7.62mm_Horizontal
R8, R10, R12: 1k; R_Axial_DIN0207_L6.3mm_D2.5mm_P7.62mm_Horizontal
R13: 2k2; R_Axial_DIN0207_L6.3mm_D2.5mm_P7.62mm_Horizontal
R43: Shunt I>30a; RESC11050X120N
RV1: 1k
SW1: Test Enable; SW_PUSH_6mm
TP1: LM393 - in; TestPoint_THTPad_3.0x3.0mm_Drill1.5mm
TP2: +5v; TestPoint_THTPad_3.0x3.0mm_Drill1.5mm
TP3: i_Sense; TestPoint_THTPad_3.0x3.0mm_Drill1.5mm
TP4: INP; TestPoint_THTPad_3.0x3.0mm_Drill1.5mm
U1: LM393; DIP-8_W7.62mm_Socket
U2: L78L05_TO92; TO-92_Inline-mod
U9: ACS712xLCTR-30A; SOIC-8_3.9x4.9mm_P1.27mm

Connections:
+5V: C3.2, C11.1, C22.1, R6.1, R7.1, R9.1, RV1.2, RV1.3, TP2.1 (1_1), U1.5 (+), U1.8 (V+), U2.1 (VO), U9.8 (VCC)
+12V: C2.2, C5.2, C9.2, C10.1, CN1.4, D1.1 (K), IC1.1 (VCC), K2.2 (COIL_1), U2.3 (VI)
/50vAmp: C13.1, C23.1, D3.1 (K), H2.1 (1_1), R43.2, U9.3 (IP-), U9.4 (IP-)
/50v_IN: H1.1 (1_1), K2.3 (COM_1), K2.4 (COM_2), Q1.3 (S)
/50v_Out: C1.2, H7.1 (1_1), IC1.8 (TS), Q1.2 (D), R2.2, R3.2, R4.1, R43.1, U9.1 (IP+), U9.2 (IP+)
/712OUT: C27.1, R8.1, R12.1, U9.7 (VIOUT)
/DISABLE: FB2.1, Q5.2 (G), R11.1
/DISABLE2: FB1.1, Q7.2 (G), R14.1
/ENABLE: CN1.1, R13.2
/INP: C8.2, CN1.6, IC1.4 (INP), Q2.3 (D), Q4.3 (D), Q5.3 (D), Q7.3 (D), R6.2, TP4.1 (1_1)
/i_sense: C12.1, CN1.5, R12.2, TP3.1 (1_1)
GND: C3.1, C4.1, C5.1, C6.1, C7.1, C8.1, C9.1, C10.2, C11.2, C12.2, C13.2, C22.2, C23.2, C25.1, C27.2, CN1.7, CN1.8, D2.2 (A), D3.2 (A), H3.1 (1_1), H4.1 (1_1), H5.1 (1_1), H6.1 (1_1), IC1.3 (GND_1), IC1.5 (OVLO), IC1.11 (GND_2), Q2.1 (S), Q3.1 (S), Q4.1 (S), Q5.1 (S), Q6.3 (E), Q7.1 (S), R5.2, R10.2, R11.2, R14.2, SW1.1, U1.4 (V-), U1.6 (-), U2.2 (GND), U9.5 (GND)
unnamed: CN1.2, FB1.2
unnamed: CN1.3, FB2.2
unnamed: C2.1, D1.2 (A), K2.5 (COIL_2), Q6.1 (C), SW1.2
unnamed: D2.1 (K), Q3.2 (G), R4.2, R5.1
unnamed: C1.1, IC1.9 (BST)
unnamed: IC1.6 (TGDN), IC1.7 (TGUP), R1.2
unnamed: K2.1 (NO), R2.1, R3.1
unnamed: Q1.1 (G), R1.1
unnamed: C4.2, Q2.2 (G), R9.2, U1.1
unnamed: Q3.3 (D), Q4.2 (G), R7.2
unnamed: Q6.2 (B), R13.1
unnamed: C6.2, R8.2, U1.3 (+)
unnamed: C7.2, R10.1, RV1.1, TP1.1 (1_1), U1.2 (-)
unnamed: C25.2, U9.6 (FILTER)

Notes on the sheet:
Current Sense

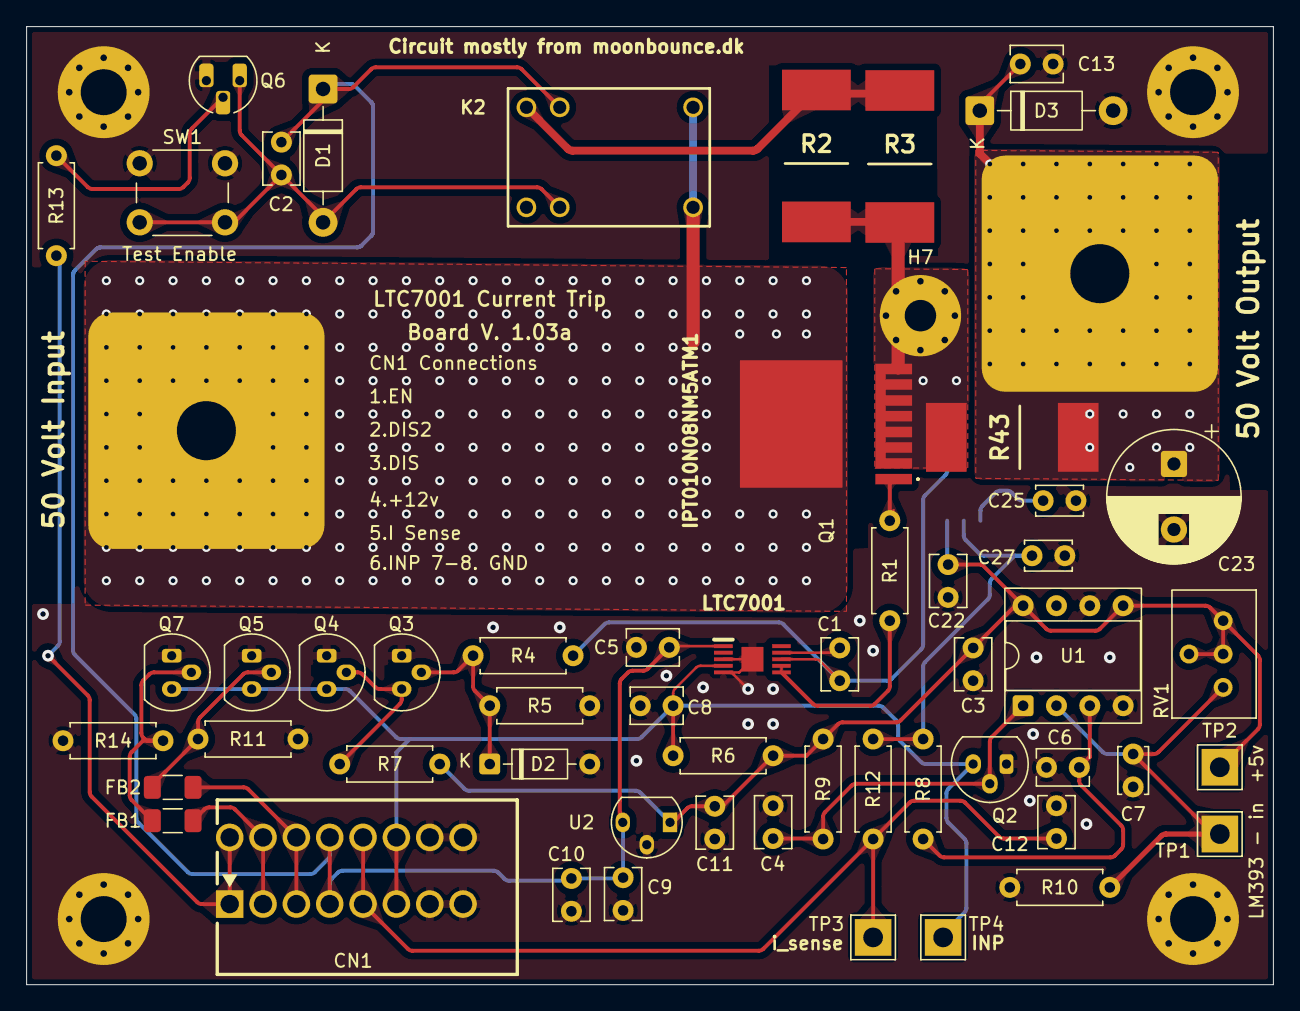
[picture p20: board LTC-7001-Trip_B.kicad_pcb from above]

Board: 2 copper layers, 95.0 x 73.0 mm, 63 parts (1 on the bottom side), 26 nets.
