satspares/LDMOS_Controller/Kicad/Kicad-all-band-amp-April-2026/all-band-amp-April-2026/all-band-amp-April-2026.kicad_pcb

## KiCad design Kicad/Kicad-all-band-amp-April-2026/all-band-amp-April-2026/all-band-amp-April-2026.kicad_pcb (2026-10-16)

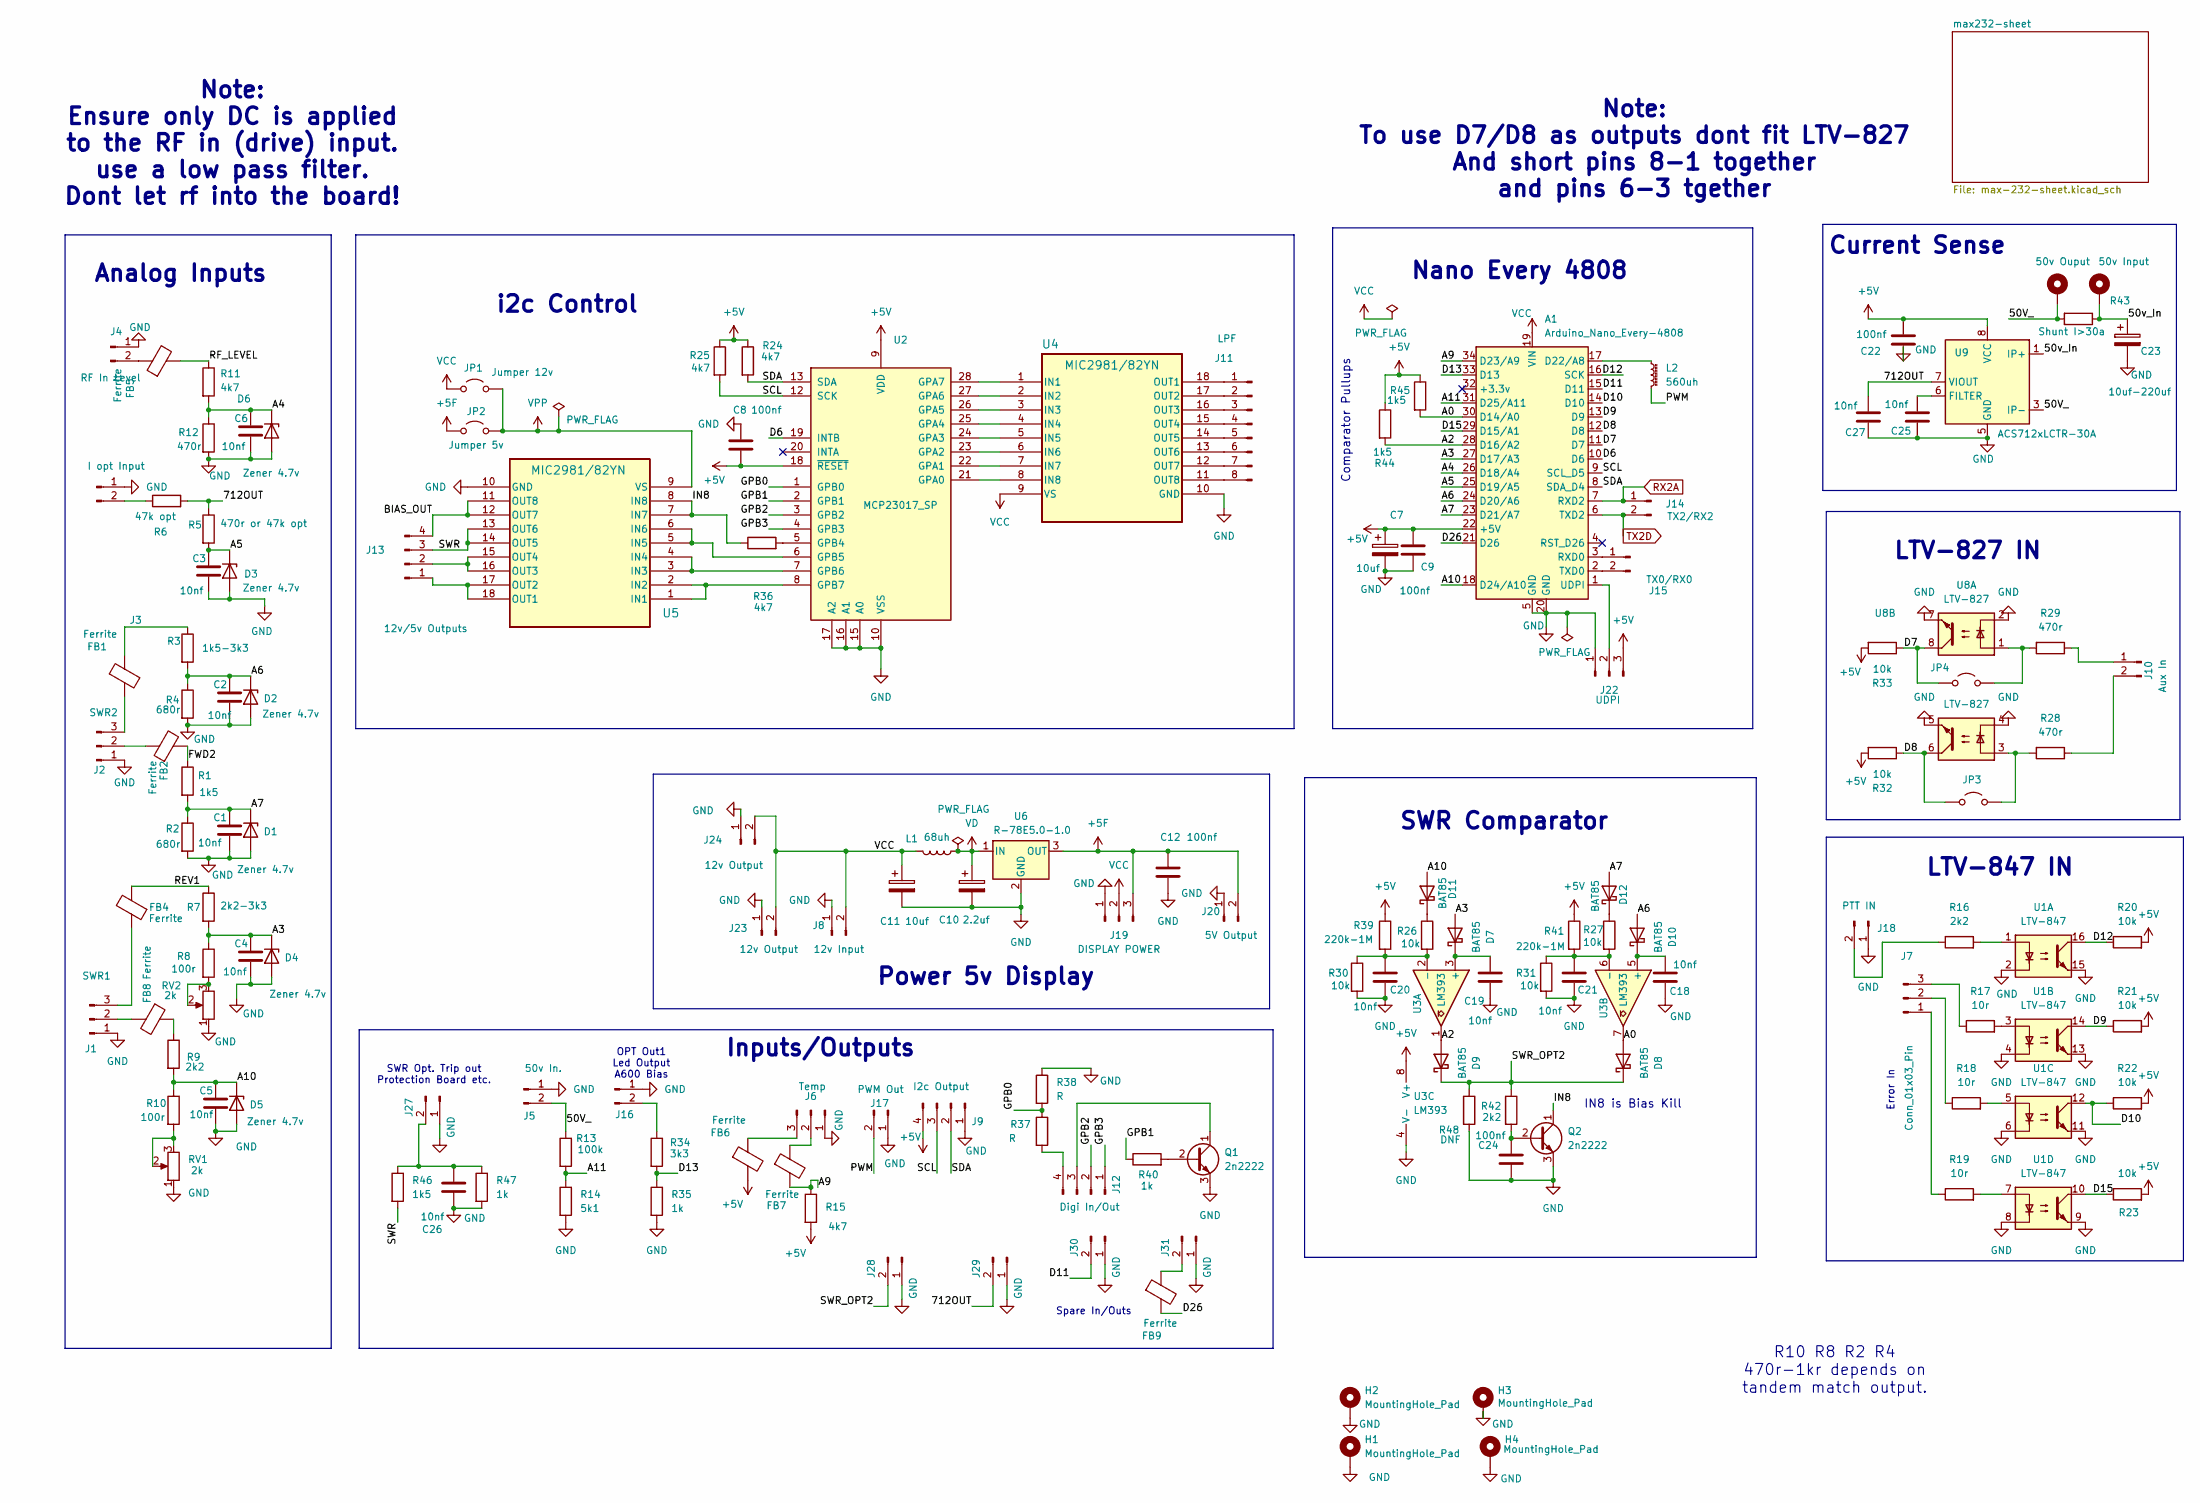
[picture p21: schematic all-band-amp-April-2026.kicad_sch, LDMOS Controller 2026 v2.10]

Parts:
A1: Arduino_Nano_Every-4808; DIP-34_W15.24mm
C1, C2, C3, C4, C5, C6, C18, C19, C20, C21, C25, C26, C27: 10nf; C_Disc_D3.4mm_W2.1mm_P2.50mm
C7, C11: 10uf; CP_Radial_D5.0mm_P2.00mm
C8, C9, C12, C22, C24: 100nf; C_Disc_D6.0mm_W2.5mm_P5.00mm
C10: 2.2uf; CP_Radial_D5.0mm_P2.00mm
C23: 10uf-220uf; CP_Radial_D10.0mm_P5.00mm
D1, D2, D3, D4, D5, D6: Zener 4.7v; D_DO-35_SOD27_P7.62mm_Horizontal
D7, D8, D9, D10, D11, D12: BAT85; D_DO-35_SOD27_P7.62mm_Horizontal
FB1, FB2, FB4, FB5, FB6, FB7, FB8, FB9: Ferrite; R_1206_3216Metric_Pad1.30x1.75mm_HandSolder-mod
H1, H2, H3, H4: MountingHole_Pad; MountingHole_3.5mm_Pad_Via
H5: 50v Ouput; PowerPad9mm
H6: 50v Input; PowerPad9mm
J1: SWR1; JST_EH_B3B-EH-A_1x03_P2.50mm_Vertical-mod2
J2: SWR2; JST_EH_B3B-EH-A_1x03_P2.50mm_Vertical-mod2
J3: I opt Input; JST_EH_B2B-EH-A_1x02_P2.50mm_Vertical-Mod
J4: RF In Level; JST_EH_B2B-EH-A_1x02_P2.50mm_Vertical-Mod
J5, J16: 50v In.; JST_EH_B2B-EH-A_1x02_P2.50mm_Vertical-Mod
J6: Temp; JST_EH_B3B-EH-A_1x03_P2.50mm_Vertical-mod2
J7: Conn_01x03_Pin; JST_EH_B3B-EH-A_1x03_P2.50mm_Vertical-mod2
J8: 12v Input; JST_EH_B2B-EH-A_1x02_P2.50mm_Vertical-Mod
J9: I2c Output; JST_EH_B4B-EH-A_1x04_P2.50mm_Vertical-mod2
J10: Aux In; JST_EH_B2B-EH-A_1x02_P2.50mm_Vertical-Mod
J11: LPF; JST_EH_B8B-EH-A_1x08_P2.50mm_Vertical
J12: Digi In/Out; JST_EH_B4B-EH-A_1x04_P2.50mm_Vertical-mod2
J13: 12v/5v Outputs; JST_EH_B4B-EH-A_1x04_P2.50mm_Vertical-mod2
J14: TX2/RX2; JST_EH_B2B-EH-A_1x02_P2.50mm_Vertical-Mod
J15: TX0/RX0; JST_EH_B2B-EH-A_1x02_P2.50mm_Vertical-Mod
J17: PWM Out; JST_EH_B2B-EH-A_1x02_P2.50mm_Vertical-Mod
J18: PTT IN; JST_EH_B2B-EH-A_1x02_P2.50mm_Vertical-Mod
J19: DISPLAY POWER; JST_EH_B3B-EH-A_1x03_P2.50mm_Vertical-mod2
J20: 5V Output; JST_EH_B2B-EH-A_1x02_P2.50mm_Vertical-Mod
J22: UDPI; JST_EH_B3B-EH-A_1x03_P2.50mm_Vertical
J23, J24: 12v Output; JST_EH_B2B-EH-A_1x02_P2.50mm_Vertical-Mod
J27, J28, J29, J30, J31: SWR trip out; JST_EH_B2B-EH-A_1x02_P2.50mm_Vertical-Mod
JP1: Jumper 12v; SolderWire-0.5sqmm_1x02_P4.8mm_D0.9mm_OD2.3mm
JP2: Jumper 5v; SolderWire-0.5sqmm_1x02_P4.8mm_D0.9mm_OD2.3mm
JP3, JP4: Jumper_2_Open; SolderJumper-2_P1.3mm_Open_TrianglePad1.0x1.5mm
L1: 68uh; L_Radial_D7.0mm_P3.00mm
L2: 560uh; L_Axial_L5.3mm_D2.2mm_P7.62mm_Horizontal_Vishay_IM-1
Q1, Q2: 2n2222; TO-92_HandSolder
R1, R44, R45, R46: 1k5; R_Axial_DIN0207_L6.3mm_D2.5mm_P7.62mm_Horizontal
R2, R4: 680r; R_Axial_DIN0207_L6.3mm_D2.5mm_P7.62mm_Horizontal
R3: 1k5-3k3; R_Axial_DIN0207_L6.3mm_D2.5mm_P7.62mm_Horizontal
R5: 470r or 47k opt; R_Axial_DIN0207_L6.3mm_D2.5mm_P7.62mm_Horizontal
R6: 47k opt; R_Axial_DIN0207_L6.3mm_D2.5mm_P7.62mm_Horizontal
R7: 2k2-3k3; R_Axial_DIN0207_L6.3mm_D2.5mm_P7.62mm_Horizontal
R8, R10: 100r; R_Axial_DIN0207_L6.3mm_D2.5mm_P7.62mm_Horizontal
R9, R16, R42: 2k2; R_Axial_DIN0207_L6.3mm_D2.5mm_P7.62mm_Horizontal
R11: 4k7; R_Axial_DIN0204_L3.6mm_D1.6mm_P5.08mm_Horizontal
R12: 470r; R_Axial_DIN0204_L3.6mm_D1.6mm_P5.08mm_Horizontal
R13: 100k; R_Axial_DIN0207_L6.3mm_D2.5mm_P7.62mm_Horizontal
R14: 5k1; R_Axial_DIN0207_L6.3mm_D2.5mm_P7.62mm_Horizontal
R15, R24, R25, R36: 4k7; R_Axial_DIN0207_L6.3mm_D2.5mm_P7.62mm_Horizontal
R17, R18, R19: 10r; R_Axial_DIN0207_L6.3mm_D2.5mm_P7.62mm_Horizontal
R20, R21, R22, R23, R26, R27, R30, R31, R32, R33: 10k; R_Axial_DIN0207_L6.3mm_D2.5mm_P7.62mm_Horizontal
R28, R29: 470r; R_Axial_DIN0207_L6.3mm_D2.5mm_P7.62mm_Horizontal
R34: 3k3; R_Axial_DIN0207_L6.3mm_D2.5mm_P7.62mm_Horizontal
R35, R40, R47: 1k; R_Axial_DIN0207_L6.3mm_D2.5mm_P7.62mm_Horizontal
R37, R38: R; R_Axial_DIN0207_L6.3mm_D2.5mm_P7.62mm_Horizontal
R39, R41: 220k-1M; R_Axial_DIN0207_L6.3mm_D2.5mm_P7.62mm_Horizontal
R43: Shunt I>30a; CHSA3920R0003F-MOD
R48: DNF; R_Axial_DIN0207_L6.3mm_D2.5mm_P7.62mm_Horizontal
RV1, RV2: 2k; Potentiometer_Bourns_3299Y_Vertical
U1: LTV-847; DIP-16_W7.62mm
U2: MCP23017_SP; DIP-28_W7.62mm
U3: LM393; DIP-8_W7.62mm
U4, U5: MIC2981/82YN; DIP-18_W7.62mm_Socket
U6: R-78E5.0-1.0; Converter_DCDC_RECOM_R-78E-0.5_THT
U8: LTV-827; DIP-8_W7.62mm
U9: ACS712xLCTR-30A; SOIC-8_3.9x4.9mm_P1.27mm

Connections:
+5F: C12.1, J19.3, J20.2, JP2.1 (A), U6.3 (OUT); also elsewhere on the board
+5V: A1.22 (+5V), C7.1, C8.2, C9.1, C22.1, FB6.2, J9.4, J22.3, R15.2, R20.2, R21.2, R22.2, R23.2, R24.1, R25.1, R32.2, R33.2, R39.1, R41.1, R44.1, R45.1, U2.9 (VDD), U2.18 (~RESET), U3.8 (V+), U9.8 (VCC)
/50V_: H5.1 (1_1), J5.2, R13.1, R43.2, U9.3 (IP-), U9.4 (IP-)
/50v_In: C23.1, H6.1 (1_1), R43.1, U9.1 (IP+), U9.2 (IP+)
/712OUT: C27.1, J29.2, R5.1, R6.2, U9.7 (VIOUT)
/A0: A1.30 (D14/A0), D8.2 (A), R45.2, U3.7
/A2: A1.28 (D16/A2), D9.2 (A), R44.2, U3.1
/A3: A1.27 (D17/A3), C4.1, D4.1 (K), D7.2 (A), R7.2, R8.1
/A4: A1.26 (D18/A4), C6.1, D6.1 (K), R11.2, R12.1
/A5: A1.25 (D19/A5), C3.1, D3.1 (K), R5.2
/A6: A1.24 (D20/A6), C2.1, D2.1 (K), D10.2 (A), R3.2, R4.1
/A7: A1.23 (D21/A7), C1.1, D1.1 (K), D12.2 (A), R1.2, R2.1
/A9: A1.34 (D23/A9), FB7.2, R15.1
/A10: A1.18 (D24/A10), C5.1, D5.1 (K), D11.2 (A), R9.2, R10.1
/A11: A1.31 (D25/A11), R13.2, R14.1
/BIAS_OUT: J13.4, U5.11 (OUT8), U5.12 (OUT7)
/D6: A1.10 (D6), U2.19 (INTB)
/D7: A1.11 (D7), JP4.1 (A), R33.1, U8.8
/D8: A1.12 (D8), JP3.1 (A), R32.1, U8.6
/D9: A1.13 (D9), R21.1, U1.14
/D10: A1.14 (D10), R22.1, U1.12
/D11: A1.15 (D11), J30.2
/D12: A1.16 (SCK), R20.1, U1.16
/D13: A1.33 (D13), R34.2, R35.1
/D15: A1.29 (D15/A1), R23.1, U1.10
/D26: A1.21 (D26), FB9.2
/FWD2: FB2.2, R1.1
/GPB0: R37.1, R38.2, U2.1 (GPB0)
/GPB1: R40.1, U2.2 (GPB1)
/GPB2: J12.2, U2.3 (GPB2)
/GPB3: J12.1, U2.4 (GPB3)
/IN8: Q2.1 (C), R36.1, U5.7 (IN7), U5.8 (IN8)
/PWM: J17.2, L2.2
/REV1: FB4.2, R7.1
/RF_LEVEL: FB5.2, R11.1
/SCL: A1.9 (SCL_D5), J9.3, R25.2, U2.12 (SCK)
/SDA: A1.8 (SDA_D4), J9.2, R24.2, U2.13 (SDA)
/SWR: J13.3, R46.2, U5.13 (OUT6), U5.14 (OUT5)
/SWR_OPT2: D8.1 (K), D9.1 (K), J28.2, R42.1, R48.1
GND: A1.5 (GND), A1.20 (GND), C1.2, C2.2, C3.2, C4.2, C5.2, C6.2, C7.2, C8.1, C9.2, C10.2, C11.2, C12.2, C18.1, C19.2, C20.2, C21.2, C22.2, C23.2, C24.2, C25.1, C26.2, C27.2, D1.2 (A), D2.2 (A), D3.2 (A), D4.2 (A), D5.2 (A), D6.2 (A), H1.1 (1_1), H2.1 (1_1), H3.1 (1_1), H4.1 (1_1), J1.1, J2.1, J3.1, J4.1, J5.1, J6.1, J8.1, J9.1, J16.1, J17.1, J18.1, J19.1, J20.1, J22.1, J23.1, J24.1, J27.1, J28.1, J29.1, J30.1, J31.1, Q1.3 (E), Q2.3 (E), R2.2, R4.2, R12.2, R14.2, R30.2, R31.2, R35.2, R38.1, R47.2, R48.2, RV1.1, RV2.1, U1.2, U1.4, U1.6, U1.8, U1.9, U1.11, U1.13, U1.15, U2.10 (VSS), U2.15 (A0), U2.16 (A1), U2.17 (A2), U3.4 (V-), U4.10 (GND), U5.10 (GND), U6.2 (GND), U8.2, U8.4, U8.5, U8.7, U9.5 (GND); also elsewhere on the board
unnamed: A1.17 (D22/A8), L2.1
unnamed: A1.3 (RXD0), J15.1
unnamed: A1.2 (TXD0), J15.2
unnamed: A1.1 (UDPI), J22.2
unnamed: C19.1, D7.1 (K), U3.3 (+)
unnamed: C18.2, D10.1 (K), U3.5 (+)
unnamed: D11.1 (K), R26.1
unnamed: D12.1 (K), R27.1
unnamed: FB1.1, R3.1
unnamed: FB8.1, R9.1
unnamed: FB8.2, J1.2
unnamed: FB4.1, J1.3
unnamed: FB2.1, J2.2
unnamed: FB1.2, J2.3
unnamed: J3.2, R6.1
unnamed: FB5.1, J4.2
unnamed: FB7.1, J6.2
unnamed: FB6.1, J6.3
unnamed: J7.1, R19.1
unnamed: J7.2, R18.1
unnamed: J7.3, R17.1
unnamed: J10.1, R29.1
unnamed: J10.2, R28.1
unnamed: J11.1, U4.18 (OUT1)
unnamed: J11.2, U4.17 (OUT2)
unnamed: J11.3, U4.16 (OUT3)
unnamed: J11.4, U4.15 (OUT4)
unnamed: J11.5, U4.14 (OUT5)
unnamed: J11.6, U4.13 (OUT6)
unnamed: J11.7, U4.12 (OUT7)
unnamed: J11.8, U4.11 (OUT8)
unnamed: J12.3, Q1.1 (C)
unnamed: J12.4, R37.2
unnamed: J13.1, U5.17 (OUT2), U5.18 (OUT1)
unnamed: J13.2, U5.15 (OUT4), U5.16 (OUT3)
unnamed: J16.2, R34.1
unnamed: J18.2, R16.1
unnamed: C26.1, J27.2, R46.1, R47.1
unnamed: FB9.1, J31.2
unnamed: JP3.2 (B), R28.2, U8.3
unnamed: JP4.2 (B), R29.2, U8.1
unnamed: Q1.2 (B), R40.2
unnamed: C24.1, Q2.2 (B), R42.2
unnamed: R8.2, RV2.2, RV2.3
unnamed: R10.2, RV1.2, RV1.3
unnamed: R16.2, U1.1
unnamed: R17.2, U1.3
unnamed: R18.2, U1.5
unnamed: R19.2, U1.7
unnamed: U2.21 (GPA0), U4.8 (IN8)
unnamed: U2.22 (GPA1), U4.7 (IN7)
unnamed: U2.23 (GPA2), U4.6 (IN6)
unnamed: U2.24 (GPA3), U4.5 (IN5)
unnamed: U2.25 (GPA4), U4.4 (IN4)
unnamed: U2.26 (GPA5), U4.3 (IN3)
unnamed: U2.27 (GPA6), U4.2 (IN2)
unnamed: U2.28 (GPA7), U4.1 (IN1)
unnamed: R36.2, U2.5 (GPB4)
unnamed: U2.6 (GPB5), U5.5 (IN5), U5.6 (IN6)
unnamed: U2.7 (GPB6), U5.3 (IN3), U5.4 (IN4)
unnamed: U2.8 (GPB7), U5.1 (IN1), U5.2 (IN2)
unnamed: C20.1, R26.2, R30.1, R39.2, U3.2 (-)
unnamed: C21.1, R27.2, R31.1, R41.2, U3.6 (-)
unnamed: C25.2, U9.6 (FILTER)
RX2A: A1.7 (RXD2), J14.1; also elsewhere on the board
TX2D: A1.6 (TXD2), J14.2; also elsewhere on the board
VCC: A1.19 (VIN), C11.1, J8.2, J19.2, J23.2, J24.2, JP1.1 (A), L1.2, U4.9 (VS)
VD: C10.1, L1.1, U6.1 (IN)
VPP: JP1.2 (B), JP2.2 (B), U5.9 (VS)

Notes on the sheet:
SWR Opt. Trip out Protection Board etc.
LTV-847 IN
Note: Ensure only DC is applied to the RF in (drive) input. use a low pass filter. Dont let rf into the board!
Analog Inputs
Inputs/Outputs
Current Sense
OPT Out1 Led Output A600 Bias
Spare In/Outs
Note: To use D7/D8 as outputs dont fit LTV-827 And short pins 8-1 together and pins 6-3 tgether
Nano Every 4808
SWR Comparator
R10 R8 R2 R4 470r-1kr depends on tandem match output.
i2c Control
LTV-827 IN
Error In
IN8 is Bias Kill
Power 5v Display
Comparator Pullups

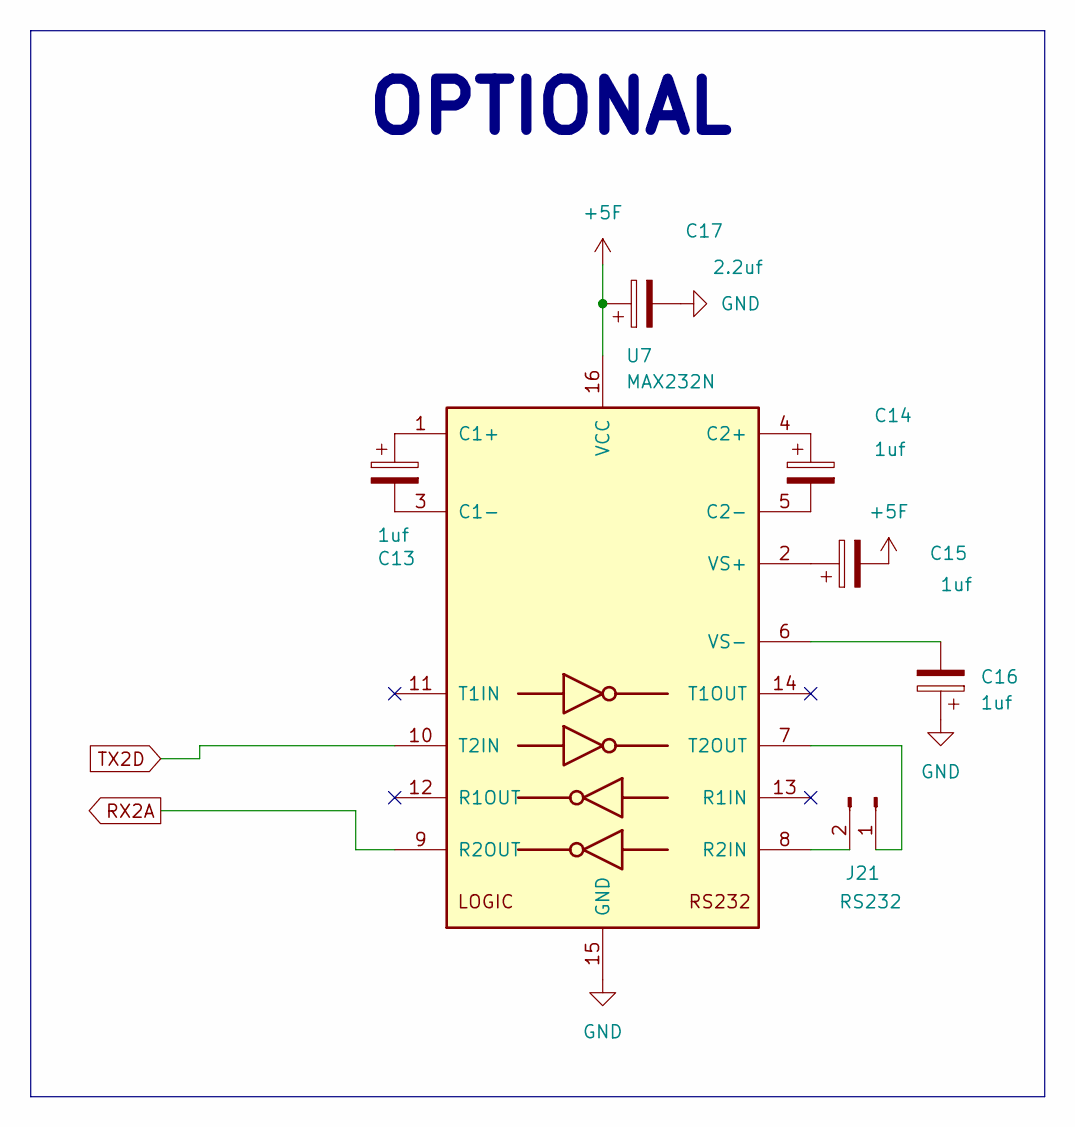
[picture p22: schematic max-232-sheet.kicad_sch]

Parts:
C13, C14, C15, C16: 1uf; CP_Radial_D5.0mm_P2.00mm
C17: 2.2uf; CP_Radial_D5.0mm_P2.00mm
J21: RS232; JST_EH_B2B-EH-A_1x02_P2.50mm_Vertical-Mod
U7: MAX232N; DIP-16_W7.62mm

Connections:
+5F: C15.2, C17.1, U7.16 (VCC); also elsewhere on the board
GND: C16.1, C17.2, U7.15 (GND); also elsewhere on the board
unnamed: J21.1, U7.7 (T2OUT)
unnamed: J21.2, U7.8 (R2IN)
unnamed: C13.1, U7.1 (C1+)
unnamed: C13.2, U7.3 (C1-)
unnamed: C14.1, U7.4 (C2+)
unnamed: C14.2, U7.5 (C2-)
unnamed: C15.1, U7.2 (VS+)
unnamed: C16.2, U7.6 (VS-)
RX2A: U7.9 (R2OUT); also elsewhere on the board
TX2D: U7.10 (T2IN); also elsewhere on the board

Notes on the sheet:
OPTIONAL

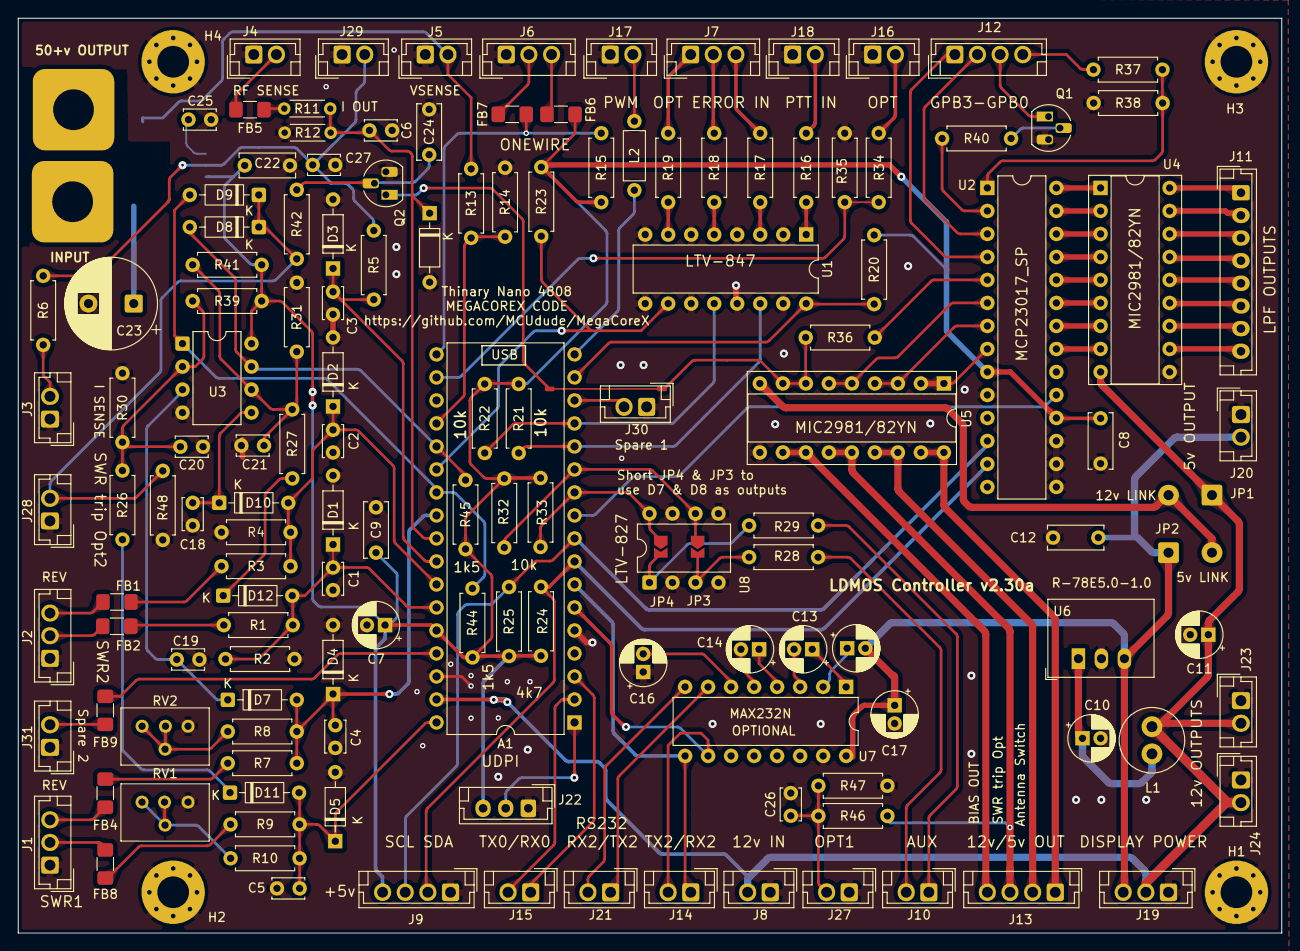
[picture p23: board all-band-amp-April-2026.kicad_pcb from above]

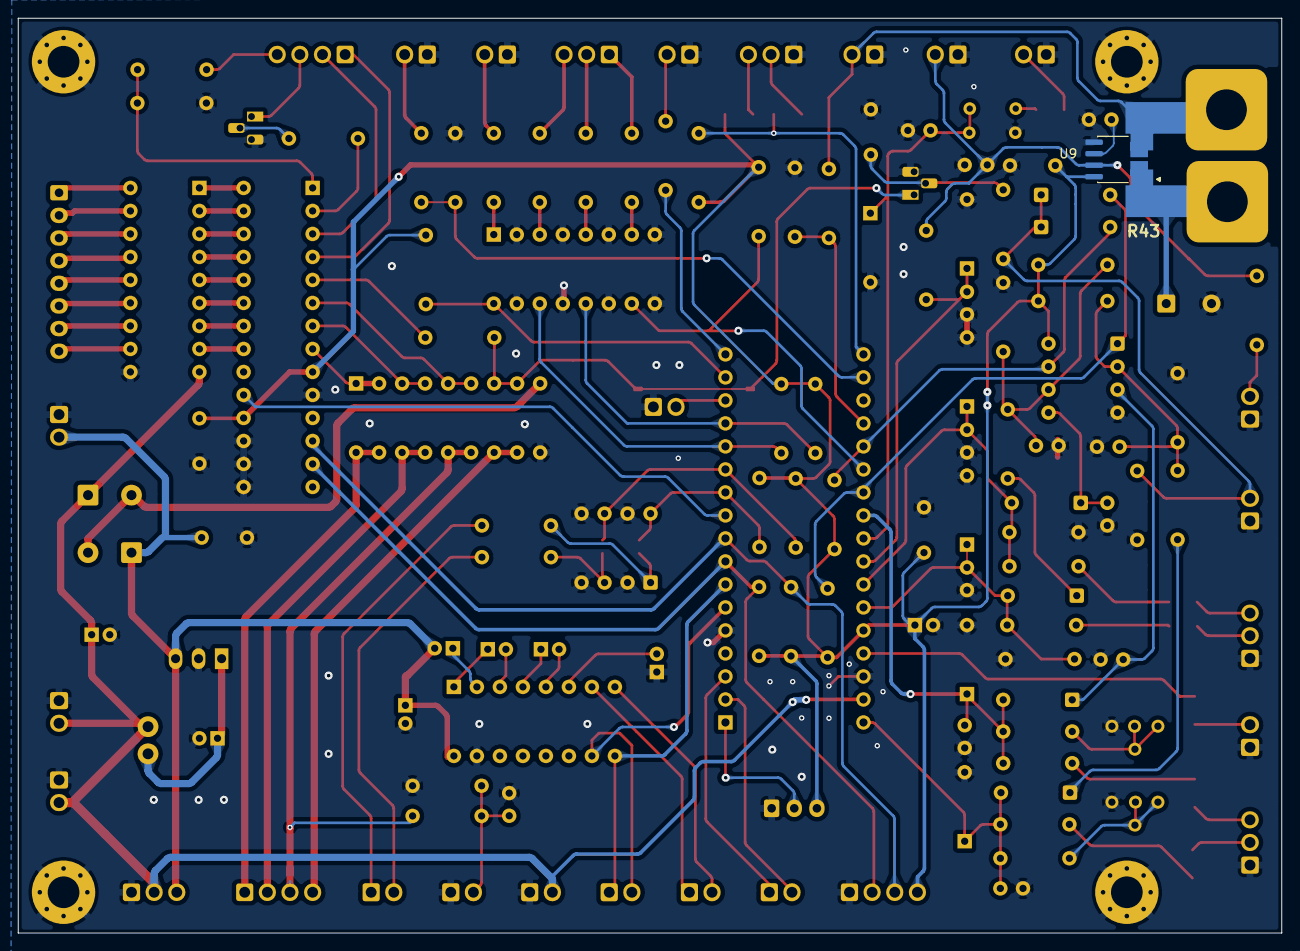
[picture p24: board all-band-amp-April-2026.kicad_pcb from below]

Board: 2 copper layers, 139.5 x 101.0 mm, 150 parts (2 on the bottom side), 117 nets.
