satspares/LDMOS_Controller/Kicad/RFA_Board/RFA_Board.kicad_pcb

## KiCad design Kicad/RFA_Board/RFA_Board.kicad_pcb (2026-10-16)

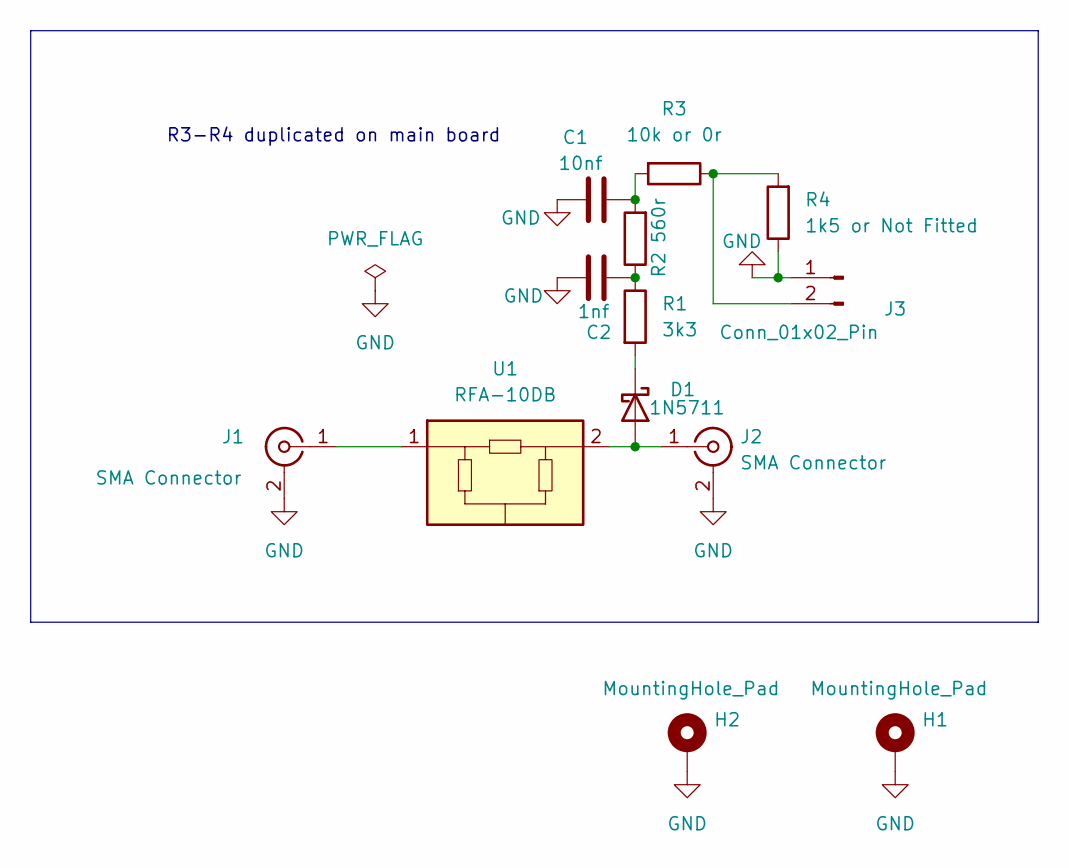
[picture p25: schematic RFA_Board.kicad_sch]

Parts:
C1: 10nf; C_1206_3216Metric_Pad1.33x1.80mm_HandSolder-mod
C2: 1nf; C_1206_3216Metric_Pad1.33x1.80mm_HandSolder-mod
D1: 1N5711; D_MELF-RM10_Universal_Handsoldering-mod
H1, H2: MountingHole_Pad; MountingHole_3.5mm_Pad_Via
J1, J2: SMA Connector; SMA_Molex_73251-2200_Horizontal_MOD
J3: Conn_01x02_Pin; SolderWirePad_1x02_SMD_12.5x8mm
R1: 3k3; R_1206_3216Metric_Pad1.30x1.75mm_HandSolder-mod
R2: 560r; R_1206_3216Metric_Pad1.30x1.75mm_HandSolder-mod
R3: 10k or 0r; R_1206_3216Metric_Pad1.30x1.75mm_HandSolder-mod
R4: 1k5 or Not Fitted; R_1206_3216Metric_Pad1.30x1.75mm_HandSolder-mod
U1: RFA-10DB; RFA Attenuator

Connections:
GND: C1.1, C2.1, H1.1 (1_1), H2.1 (1_1), J1.2 (Ext), J2.2 (Ext), J3.1, R4.1
unnamed: C1.2, R2.2, R3.2
unnamed: C2.2, R1.1, R2.1
unnamed: D1.2 (A), J2.1 (In), U1.2
unnamed: D1.1 (K), R1.2
unnamed: J1.1 (In), U1.1
unnamed: J3.2, R3.1, R4.2

Notes on the sheet:
R3-R4 duplicated on main board
