satspares/LDMOS_Controller/Kicad/RFA_Board/RFA_Board.kicad_pcb

## KiCad design Kicad/RFA_Board/RFA_Board.kicad_pcb (continued)

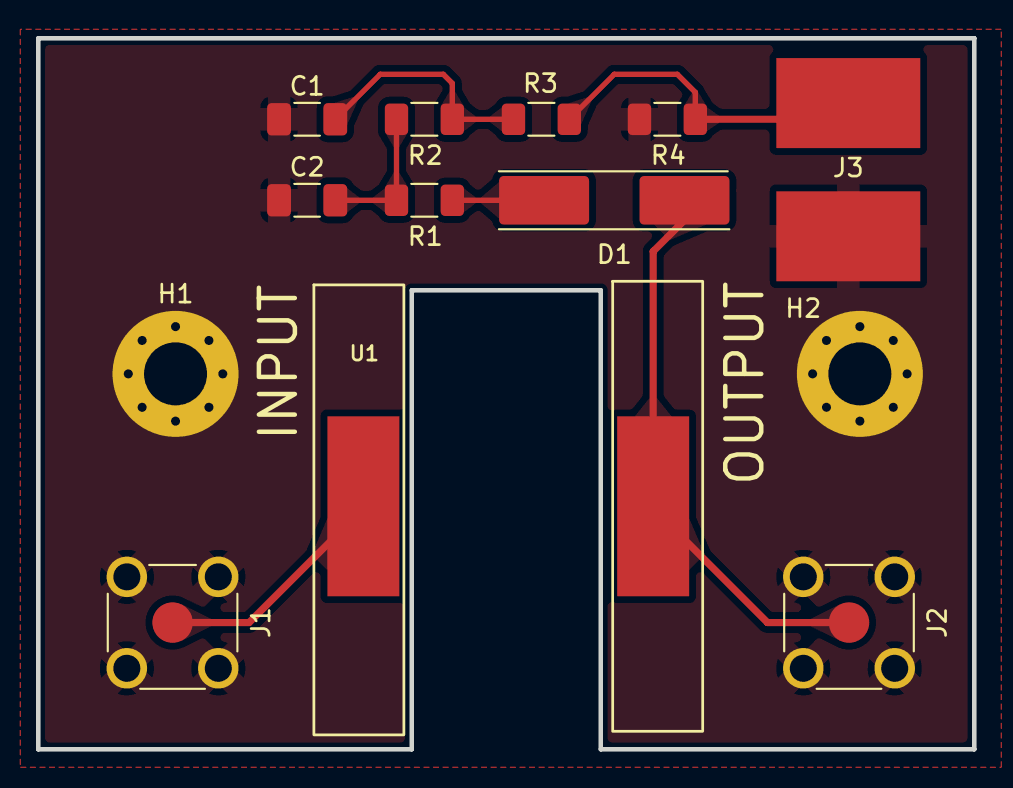
[picture p26: board RFA_Board.kicad_pcb from above]

Board: 2 copper layers, 52.0 x 39.5 mm, 13 parts (0 on the bottom side), 7 nets.
