satspares/LDMOS_Controller/Kicad/Band_Switch_board_2026/Band_Switch_board_2026_small/Band_Switch_board_2026_small.kicad_pcb

## KiCad design Kicad/Band_Switch_board_2026/Band_Switch_board_2026_small/Band_Switch_board_2026_small.kicad_pcb (2026-10-16)

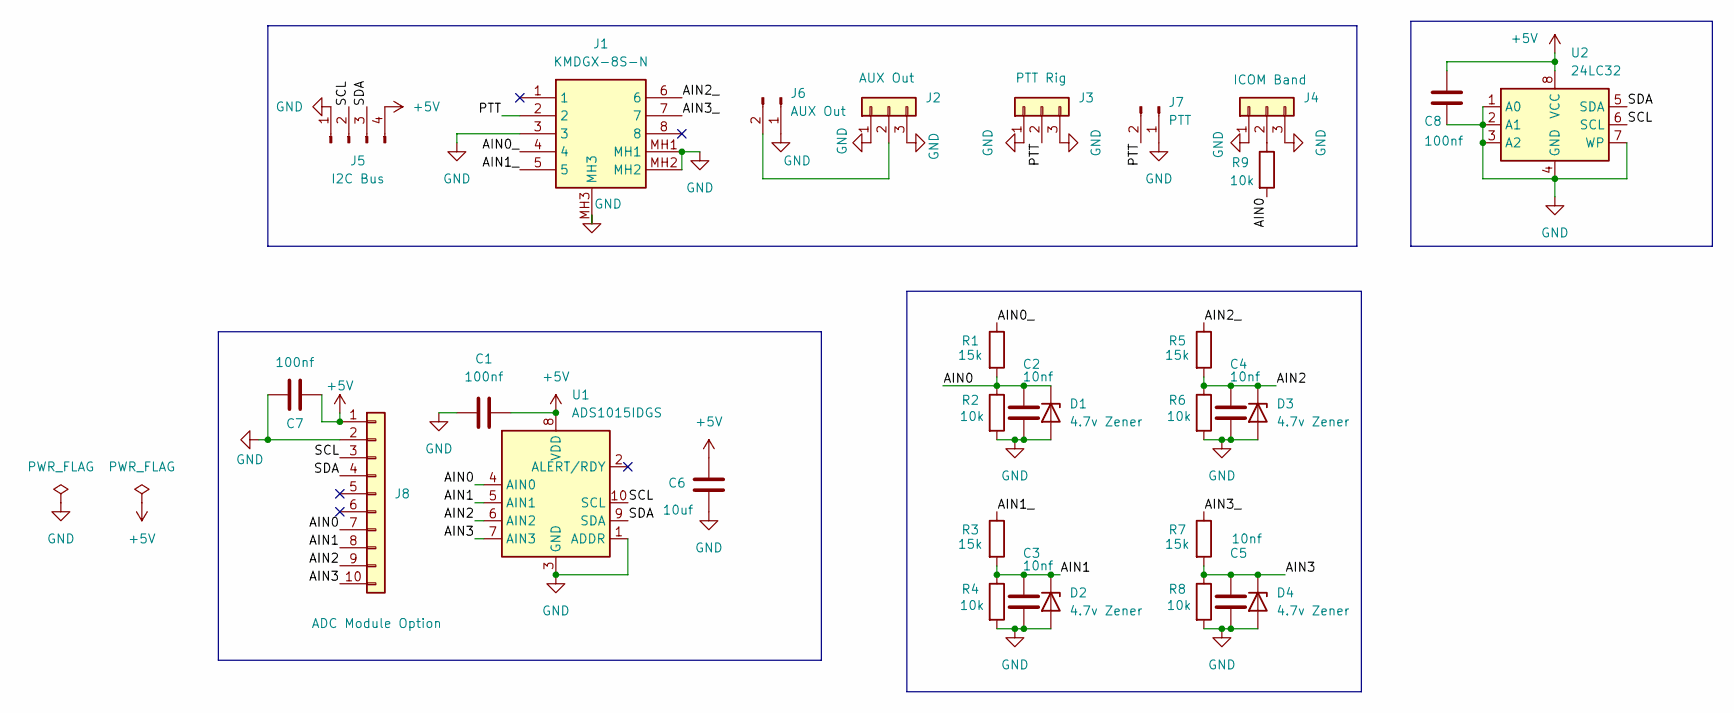
[picture p27: schematic Band_Switch_board_2026_small.kicad_sch]

Parts:
C1, C7, C8: 100nf; C_Disc_D6.0mm_W2.5mm_P5.00mm
C2, C3, C4, C5: 10nf; C_Disc_D3.4mm_W2.1mm_P2.50mm
C6: 10uf; CP_Radial_Tantal_D5.0mm_P2.50mm
D1, D2, D3, D4: 4.7v Zener; D_DO-35_SOD27_P7.62mm_Horizontal
J1: KMDGX-8S-N; KMDGX8SN; Mouser Part Number 806-KMDGX-8S-N
J2: AUX Out; BarrelJack__Horizontal_Band_Switch
J3: PTT Rig; BarrelJack__Horizontal_Band_Switch
J4: ICOM Band; BarrelJack__Horizontal_Band_Switch
J5: I2C Bus; JST_EH_B4B-EH-A_1x04_P2.50mm_Vertical
J6: AUX Out; JST_EH_B2B-EH-A_1x02_P2.50mm_Vertical
J7: PTT; JST_EH_B2B-EH-A_1x02_P2.50mm_Vertical
J8: ADC Module Option; PinHeader_1x10_P2.54mm_Vertical_ADC
R1, R3, R5, R7: 15k; R_Axial_DIN0207_L6.3mm_D2.5mm_P7.62mm_Horizontal
R2, R4, R6, R8, R9: 10k; R_Axial_DIN0207_L6.3mm_D2.5mm_P7.62mm_Horizontal
U1: ADS1015IDGS; TSSOP-10_3x3mm_P0.5mm
U2: 24LC32; DIP-8_W7.62mm_Socket

Connections:
+5V: C1.2, C6.1, C7.2, C8.2, J5.4, J8.1, U1.8 (VDD), U2.8 (VCC)
/AIN0: C2.1, D1.1 (K), J8.7, R1.2, R2.1, R9.2, U1.4 (AIN0)
/AIN0_: J1.4, R1.1
/AIN1: C3.1, D2.1 (K), J8.8, R3.2, R4.1, U1.5 (AIN1)
/AIN1_: J1.5, R3.1
/AIN2: C4.1, D3.1 (K), J8.9, R5.2, R6.1, U1.6 (AIN2)
/AIN2_: J1.6, R5.1
/AIN3: C5.1, D4.1 (K), J8.10, R7.2, R8.1, U1.7 (AIN3)
/AIN3_: J1.7, R7.1
/PTT: J1.2, J3.2, J7.2
/SCL: J5.2, J8.3, U1.10 (SCL), U2.6 (SCL)
/SDA: J5.3, J8.4, U1.9 (SDA), U2.5 (SDA)
GND: C1.1, C2.2, C3.2, C4.2, C5.2, C6.2, C7.1, C8.1, D1.2 (A), D2.2 (A), D3.2 (A), D4.2 (A), J1.3, J1.MH1, J1.MH2, J1.MH3, J2.1, J2.3, J3.1, J3.3, J4.1, J4.3, J5.1, J6.1, J7.1, J8.2, R2.2, R4.2, R6.2, R8.2, U1.1 (ADDR), U1.3 (GND), U2.1 (A0), U2.2 (A1), U2.3 (A2), U2.4 (GND), U2.7 (WP)
unnamed: J2.2, J6.2
unnamed: J4.2, R9.1

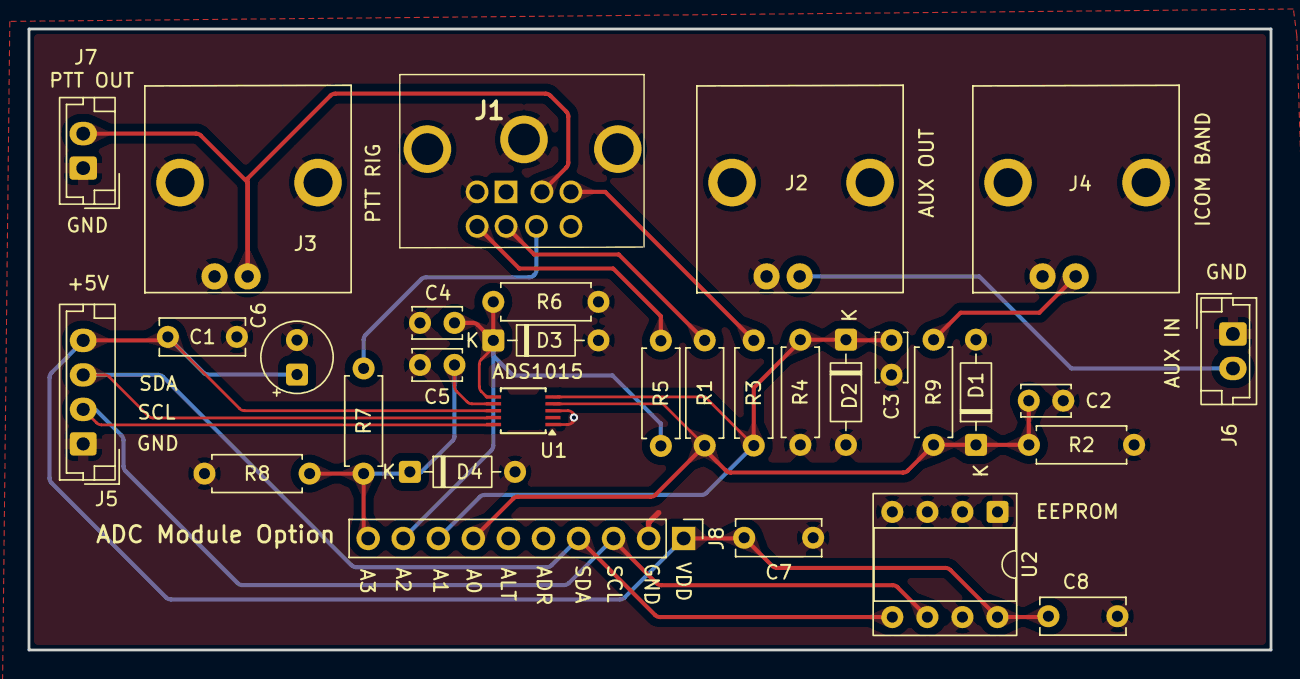
[picture p28: board Band_Switch_board_2026_small.kicad_pcb from above]

Board: 2 copper layers, 90.0 x 45.0 mm, 31 parts (0 on the bottom side), 15 nets.
